KarlaRuggaber/hands-on-HCI/hardware/steckplan/Group4-Spicetracks-Circuit-Diagram.html

Spicetracks · Elektronik

# Steckplan: ESP32-S3, zwei Breadboards, Relais, Pumpe, Motor, LEDs, Lichtsensor, Pi und vier Kräuter

Jedes Kabel ist eingezeichnet, mit Pin, Loch und Kabeltyp. Fahr mit der Maus über ein Kabel oder tipp es an, dann siehst du oben genau, von wo nach wo es geht. Mit den Knöpfen hebst du einen Bereich hervor.

Breadboard 1: 3,3 V Breadboard 2: 5 V vom ELEGOO Power MB V2 Relais: Reihe 10 Touch: Reihen 2 · 12 · 19 · 26 Feuchte: Reihen 6 · 16 · 23 · 30 Motor: GPIO 15 bis 18 LEDs: GPIO 40, Strom aus der Powerbank Licht KY-054: GPIO 6, Reihe 11

Ganzes Bild Vergrössern

Pin-Reihenfolge nach dem Espressif ESP32-S3-DevKitC-1. Bei einem Nachbau zählt der Aufdruck auf eurem Board. Breadboard 1 nutzt Reihen bis 30, Breadboard 2 Reihen bis 20; auf grösseren Boards gelten dieselben Nummern.

## Kabelliste

Nr | Von | Nach | Kabel | Wozu

## Regeln beim Stecken

1. Nur ohne Strom stecken: USB abziehen und das ELEGOO-Modul ausschalten.
2. ELEGOO Power MB V2: beide Jumper auf 5 V, Plus-Pins auf die rote Schiene. Es liefert höchstens etwa 700 mA, deshalb hängen Relais, Motor und Pumpe daran, die LEDs nicht.
3. Breadboard 1 führt auf den roten Schienen 3,3 V, Breadboard 2 führt 5 V. Die roten Schienen der beiden Boards nie miteinander verbinden.
4. Der 5V-Pin des ESP32 bleibt frei. Der ESP32 bekommt seinen Strom nur über USB vom Pi, nie zusätzlich vom Netzteil.
5. Gemeinsame Masse: Kabel S5 verbindet GND des ESP32 mit Breadboard 2. Ohne diese Verbindung schalten Relais, Motor und LEDs unzuverlässig.
6. Die Rille in der Mitte trennt a bis e von f bis j. Deshalb sitzen Widerstände und Brücken über der Rille.
7. Obere und untere Schienen eines Boards sind getrennt. Die Brücken verbinden sie.
8. Kondensator 1000 µF: nur für die LED-Versorgung, direkt am Eingang des Bügels. Der Streifen mit dem Minuszeichen kommt an GND.
9. Powerbank Intenso B10000: höchstens 2,4 A, deshalb LEDs im Code auf 1500 mA begrenzen. Schaltet sie ab, wenn alle LEDs dunkel sind, lasst ein leichtes Grundglimmen an.
10. Der Lichtsensor KY-054 bekommt nur 3,3 V. Mit 5 V wäre sein Signal zu hoch für den Analogeingang des ESP32. Am Bügel zeigt er nach oben, weg von den LEDs.
11. LED-Streifen haben eine Richtung. Der Pfeil auf dem Streifen zeigt von DIN nach DOUT. Das Kabel vom Breadboard kommt an DIN.
12. Touch-Kabel einzeln führen, nicht neben Motor- oder Pumpenkabeln.

## LED-Nummern für den Code

Stück | LED-Nummern | Hinweis
Bügel | 0 bis 27 | 0 sitzt am Kabelanfang rechts
Kraut 1 | 28 bis 30 | 3er-Stück innen am Trog
Kraut 2 | 31 bis 33
Kraut 3 | 34 bis 36
Kraut 4 | 37 bis 39 | Ende der Kette

Helligkeit im Code begrenzen, z. B. mit FastLED setMaxPowerInVoltsAndMilliamps(5, 1500). 40 LEDs auf Vollweiss brauchen sonst bis 2,4 A.

## Kommt später dazu

Teil | Pin | Hinweis
Tank-Füllstand | GPIO 7 | 5. Feuchtesensor am Tank oder Schwimmer gegen GND
Endschalter Verteiler | GPIO 39 | INPUT_PULLUP, Schalter gegen GND
Pegelwandler 74AHCT125 | GPIO 40 | nur falls die LEDs flackern, zwischen GPIO 40 und 330 Ω
