KarlaRuggaber/hands-on-HCI/hardware/3d-druck/spicetracks-dach-druckplan.pdf

# Spicetracks Dach, Variante B „Wild gewachsen“

Für Bambu-Drucker mit 256 × 256 × 256 mm. Unterkante Hauptast 30 cm über der Box, Stämme hinten in den beiden Enden des Elektronikschachts. Alles wird gesteckt, nichts geklebt. Ohne Kamera.

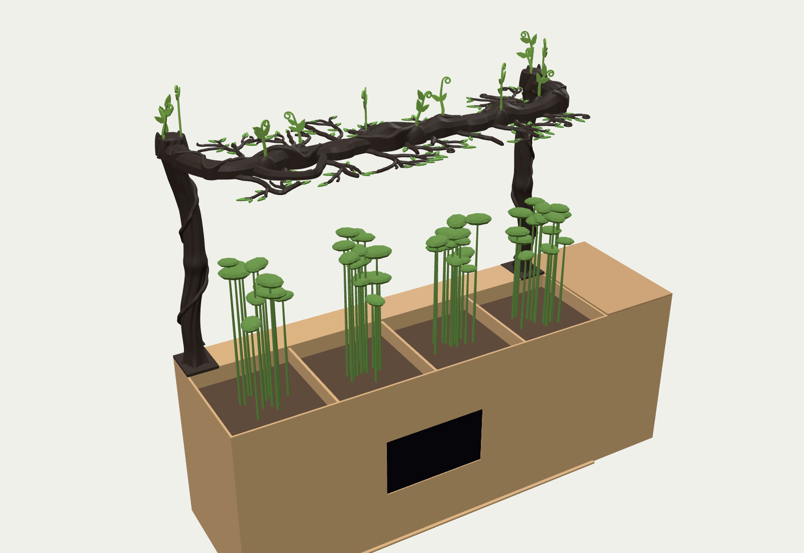
[picture p2: figure]

## Was drin ist

Stämme statt Pfosten: zwei Teile pro Stamm, gebogen und leicht verdreht, mit Rindenrillen, einem Knoten an der Steckstelle, Wurzeln auf dem Fuss und einer Ranke, die sich hochwindet. Innen hohl für die Kabel.
Kronen: Jeder Stamm endet oben in einem knorrigen Kopf, aus dem der Hauptast wächst.
Hauptast: Wülste und Buckel, darüber windet sich eine Liane. An drei Stellen wächst ein zweiter Strang heraus und wieder hinein, dort entstehen offene Schlaufen. Zweige und Blätter flach mitgedruckt, mit Blattbüscheln und kleinen Rankenspiralen an den Spitzen. Blätter grün über das AMS.
Steck-Triebe: 16 flache grüne Triebe für 13 Schlitze oben auf Kronen und Wülsten, drei als Reserve. Man kann sie jederzeit umstecken.
Technik wie bisher: LED-Nut 11 × 6 mm unten für einen 10-mm-Streifen, 467 mm lang (28 LEDs bei 60/m), Kabelkanal im Ast bis in die Stämme, Loch Ø 5.3 mm für den Lichtsensor rechts, Schwalbenschwanz-Fugen zwischen den drei Dachteilen.

## Druckplatten

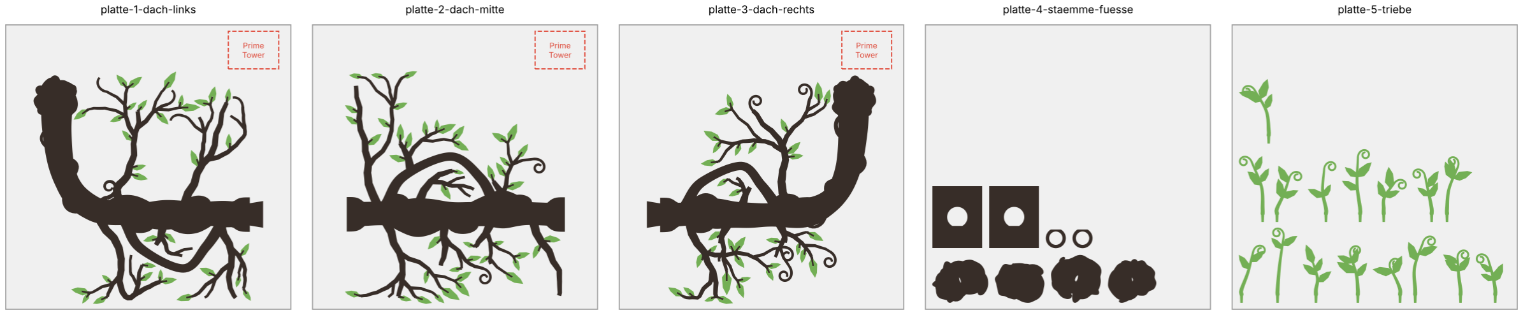
[picture p3: figure]

Platte Teil | Grösse mm | Lage
1 | Dach links | Ast + Blätter 206 × 209 × 31 flach, wie geliefert
2 | Dach Mitte | Ast + Blätter 198 × 209 × 31 flach, wie geliefert
3 | Dach rechts | Ast + Blätter 206 × 205 × 30 flach, wie geliefert
4 | Stamm links unten / oben | je 1× | 50 × 39 × 164 | stehend, Knoten auf dem Bett, Brim
4 | Stamm rechts unten / oben je 1× | 45 × 43 × 164 | stehend, Knoten auf dem Bett, Brim
4 | Pfostenfuss links + rechts | 2× | 45 × 56 × 44 | Deckel nach unten
4 | Dübel | 2× | 18 × 17 × 31 | stehend
5 | Triebe | 16× | bis 30 × 60 × 2 flach, grün

## Einstellungen

PETG, Schichthöhe 0.2 mm, 3 Wände, 15 % Infill, keine Stützen. Überhänge sind höchstens 45°, dazu kurze Brücken über Nut, Kanal und Buchsen.
Platten 1 bis 3 zweifarbig: Jede 3MF enthält ein Objekt mit den Teilen „Ast“ und „Blaetter“. Den Blättern im AMS grünes Filament zuweisen. Die Dachteile liegen vorne, hinten bleibt Platz für den Prime Tower (rot markiert). Steht er woanders, nach hinten ziehen.
Platte 4: Brim 5 mm für die Stämme, sie stehen hoch und schmal. Die unteren Stücke stehen kopfüber, die Wurzeln sind oben.
Platte 5: einfarbig grün, gern ein helleres Grün als die Blätter.
Feine Zweige: Aussenwände etwa 60 mm/s, falls Spitzen abreissen.
Die einzelnen STL-Dateien liegen auch bei, falls ihr selber anordnen wollt.

## Zusammenbau

1. Schachtdeckel: Der Laser-Deckel (Platte 04) ist 497.5 mm lang und liegt zwischen den beiden Pfostenfüssen.
2. Pfostenfüsse von oben in die Schachtenden stecken. Der Fuss mit dem Loch zur Seitenwand kommt rechts, auf die Tankseite. Der Saugschlauch geht durch Seitenwand und Fuss.
3. Stämme stecken: unteres Stück mit dem Zapfen in den Fuss, Dübel ins untere Stück, oberes Stück darauf. Zapfen und Dübel haben eine flache Seite nach hinten, so passt alles nur in der richtigen Drehung und die Ranke läuft durch. Links und rechts stehen im Dateinamen.
4. Kabel einziehen, bevor das Dach oben ist: LED-Kabel vom linken Ende der Nut durch das kleine Loch in den Kanal und weiter zur linken Krone. Den Lichtsensor oben ins Loch rechts stecken, seine Beine durch den Kanal zur rechten Krone. Ein steifer Draht als Zugdraht hilft. Stecker dürfen höchstens 11 mm breit sein, sonst erst nachher ancrimpen.
5. Dach zusammenstecken, auf dem Tisch: Aussenteile hinlegen, das Mittelteil von oben auf die beiden Zapfen setzen.
6. LED-Streifen in die Nut kleben, LEDs nach unten. Er läuft am Stück über beide Fugen und hält das Dach zusätzlich zusammen.
7. Dach aufsetzen: mit den Kronen auf die oberen Stammzapfen stecken. Die Kabel kommen durch die hohlen Stämme unten im Schacht an.
8. Triebe einstecken: Zapfen in die Schlitze drücken. Der Zapfen ist keilförmig und klemmt. Sitzt einer zu locker, einen anderen Trieb nehmen.

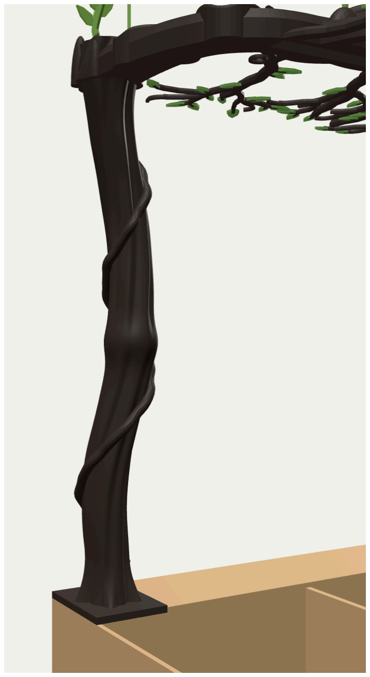
[picture p4: figure]

## Kabel

LED-Streifen: 3 Adern (5 V, GND, Daten) durch den linken Stamm zum ESP32 im Schacht. Lichtsensor: 2 Adern durch den rechten Stamm.
Die Pfostenfüsse belegen die obersten 4.5 cm an beiden Schachtenden. Platinen dort tiefer oder weiter innen montieren.

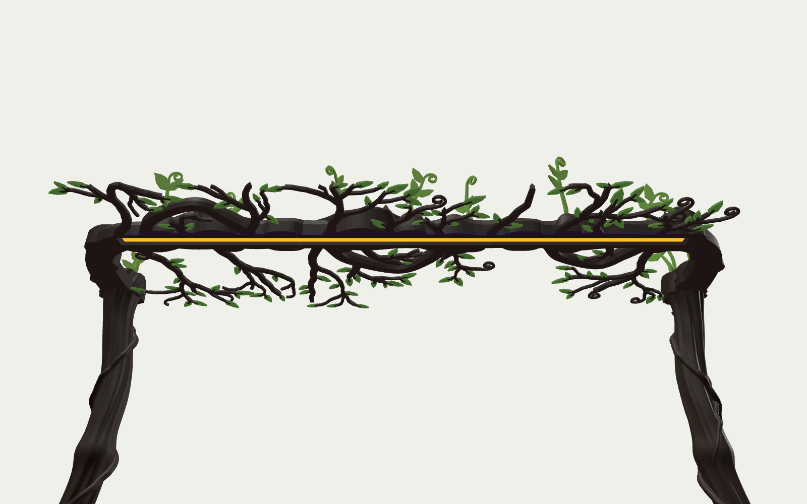
[picture p5: figure]

Von unten: LED-Nut, Schlaufen und Zweige rund um den Hauptast.

Stamm links: Wurzeln auf dem Fuss, Knoten an der Steckstelle, Ranke.
