KarlaRuggaber/hands-on-HCI/docs/skizzen/Bleistiftskizze.pdf

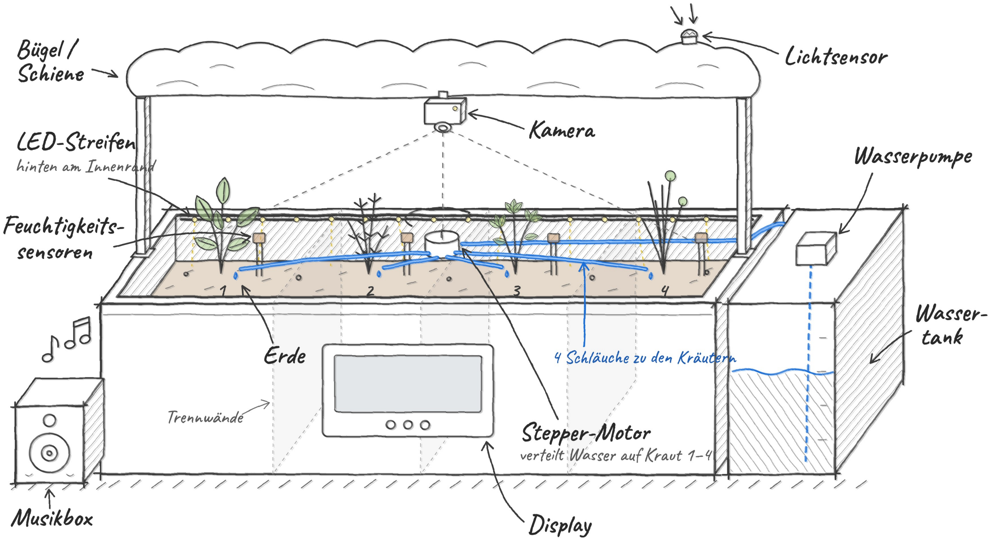
[picture p6: page 1]

1 | 2 | 3 | 4

Feuchtigkeitssensoren

LED-Streifen
hinten am Innenrand

Erde

Trennwände

Lichtsensor

Kamera

Bügel /
Schiene

Stepper-Motor
verteilt Wasser auf Kraut 1–4

Wasserpumpe

Wassertank
4 Schläuche zu den Kräutern
Musikbox | Display
