KarlaRuggaber/hands-on-HCI/docs/skizzen/Kräutergarten Dach-Ideen-selection.pdf

# Querschnitt LED-Kanal

# Teile verbinden & Kamera

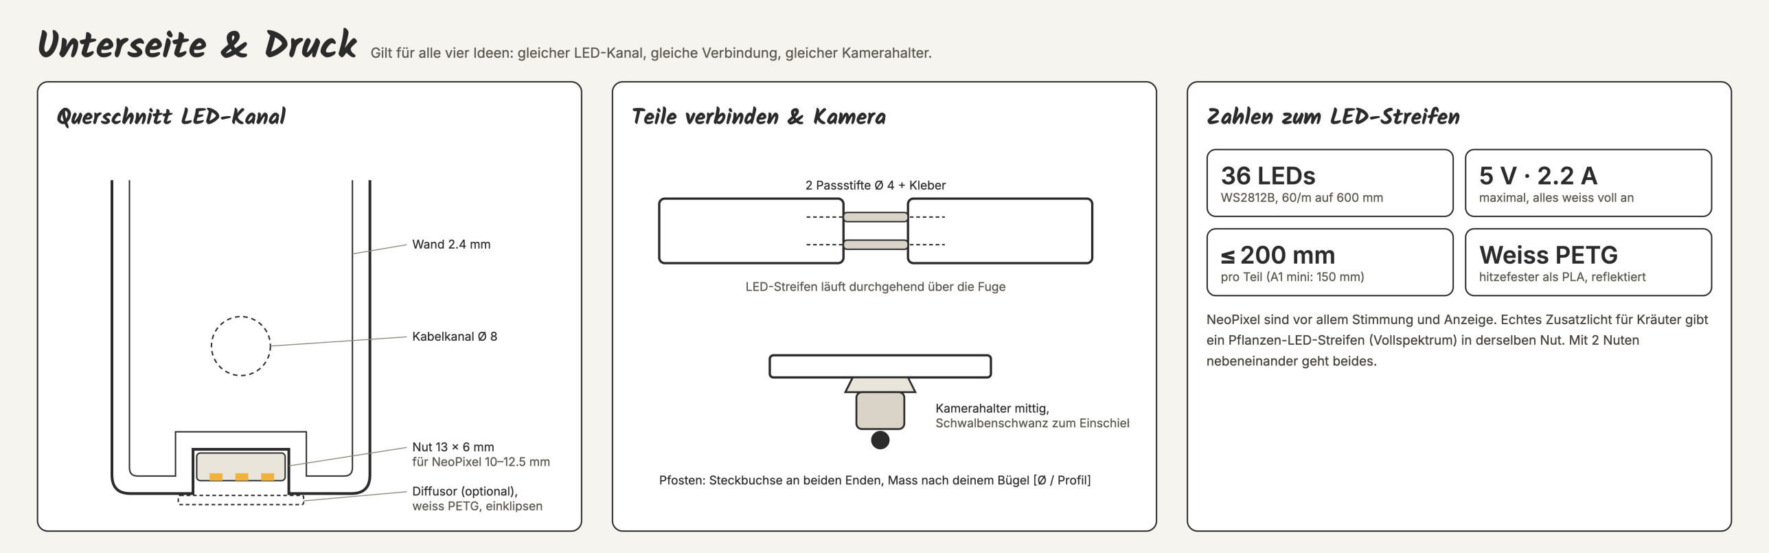
[picture p7: page 1]

Unterseite & Druck Gilt für alle vier Ideen: gleicher LED-Kanal, gleiche Verbindung, gleicher Kamerahalter.

Wand 2.4 mm

Kabelkanal Ø 8

Nut 13 × 6 mm
für NeoPixel 10–12.5 mm

Diffusor (optional),
weiss PETG, einklipsen

2 Passstifte Ø 4 + Kleber

LED-Streifen läuft durchgehend über die Fuge

Kamerahalter mittig,
Schwalbenschwanz zum Einschieben

Pfosten: Steckbuchse an beiden Enden, Mass nach deinem Bügel [Ø / Profil]

# Zahlen zum LED-Streifen

# 36 LEDs

WS2812B, 60/m auf 600 mm

5 V · 2.2 A

maximal, alles weiss voll an

≤ 200 mm

pro Teil (A1 mini: 150 mm)

# Weiss PETG

hitzefester als PLA, reflektiert

NeoPixel sind vor allem Stimmung und Anzeige. Echtes Zusatzlicht für Kräuter gibt ein Pflanzen-LED-Streifen (Vollspektrum) in derselben Nut. Mit 2 Nuten nebeneinander geht beides.

# Dicker Ast pro Kraut

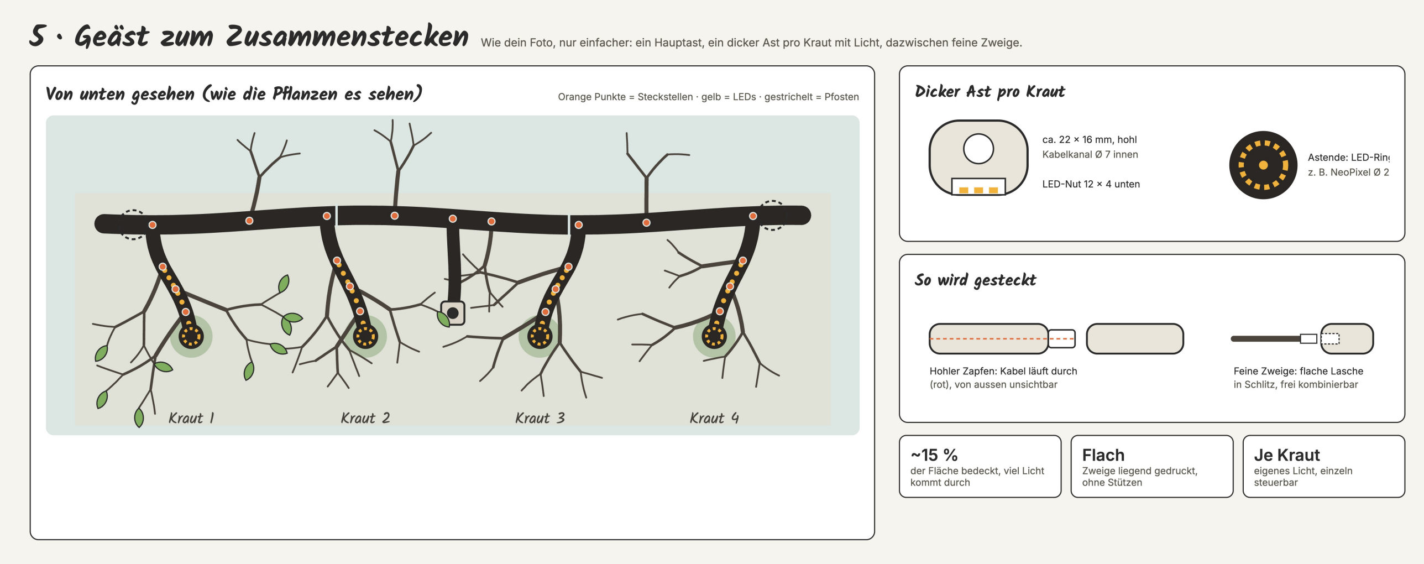
[picture p8: page 2]

5 · Geäst zum Zusammenstecken Wie dein Foto, nur einfacher: ein Hauptast, ein dicker Ast pro Kraut mit Licht, dazwischen feine Zweige.

Von unten gesehen (wie die Pflanzen es sehen) | Orange Punkte = Steckstellen · gelb = LEDs · gestrichelt = Pfosten
Kraut 1 | Kraut 2 | Kraut 3 | Kraut 4

ca. 22 × 16 mm, hohl
Kabelkanal Ø 7 innen

LED-Nut 12 × 4 unten

Astende: LED-Ring
z. B. NeoPixel Ø 23–32

# So wird gesteckt

Hohler Zapfen: Kabel läuft durch (rot), von aussen unsichtbar

Feine Zweige: flache Lasche in Schlitz, frei kombinierbar

~15 %

der Fläche bedeckt, viel Licht kommt durch

# Flach

Zweige liegend gedruckt,
ohne Stützen

# Je Kraut

eigenes Licht, einzeln
steuerbar

# A · Symmetrisch

Gleichmässige Äste im Takt, links und rechts gespiegelt. Ruhig und aufgeräumt.

## vorne

## hinten

Alle Seitenäste gleich, nur 2 Formen drucken | Rhythmus 70 mm, passt zu jedem Kraut | ~15 % der Fläche bedeckt

# B · Wild gewachsen

Leicht gewellter Hauptast, unregelmässige Äste, mehr Zweige. Am nächsten an deinem Foto.

## vorne

## hinten

Jeder Seitenast anders, wirkt wie echter Baum

Feinste Zweige ca. 1.5 mm, langsam drucken | ~22 % der Fläche bedeckt

# C · Gabel pro Kraut

Über jedem Kraut gabelt sich ein V nach vorne und hinten. Man sieht sofort, welches Licht zu welcher Pflanze gehört.

## vorne

## hinten

4 Gabel-Module, je eins pro Kraut | Optional LED in den Gabelästen | ~18 % der Fläche bedeckt

# D · Minimal

Wenige lange, feine Äste und kaum Blätter. Sehr leicht, fast nur Linie.

## vorne

## hinten

Nur 9 Seitenäste, alle flach druckbar | Wenig Material, sehr schnell gedruckt | ~10 % der Fläche bedeckt
