KarlaRuggaber/hands-on-HCI/docs/abbildungen/entwuerfe.jpg

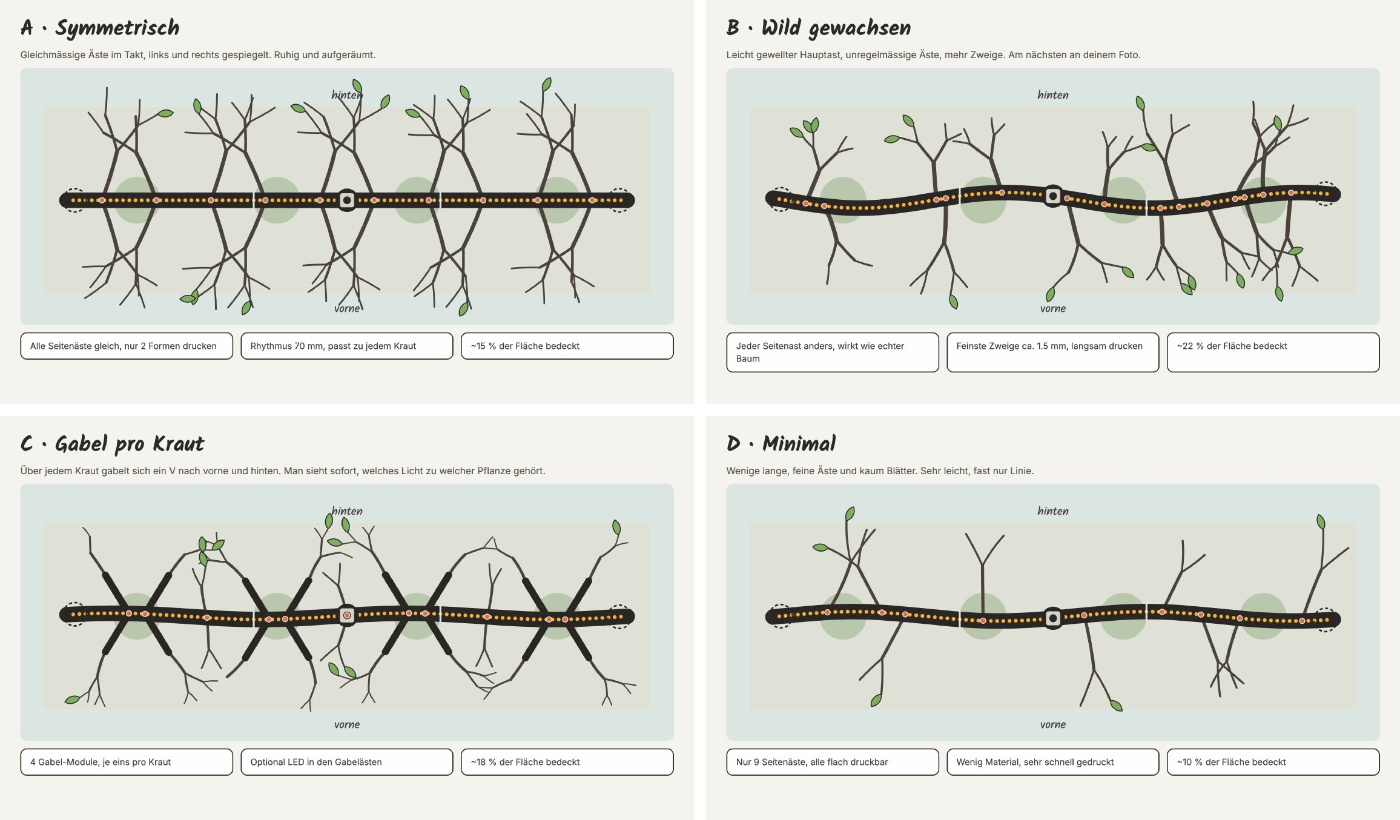
docs/abbildungen/entwuerfe.jpg
