KarlaRuggaber/hands-on-HCI/docs/abbildungen/gehaeuse.jpg

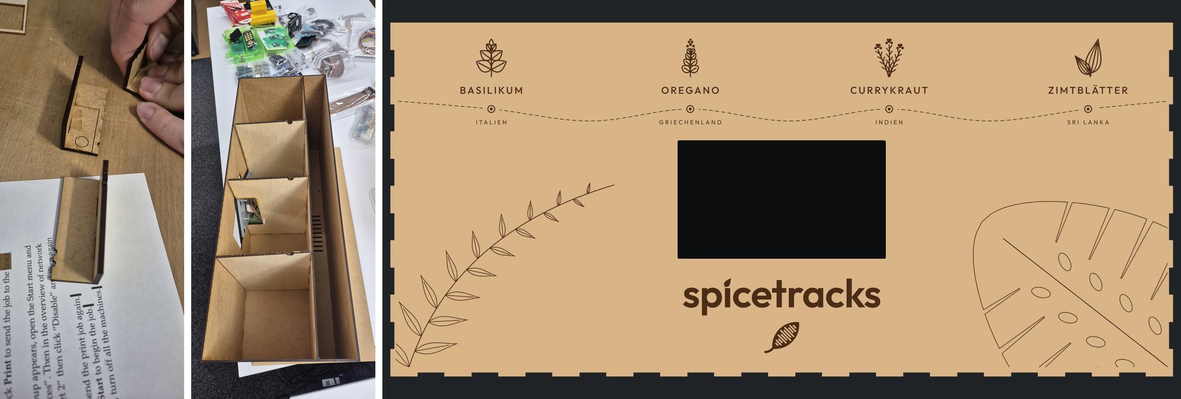
docs/abbildungen/gehaeuse.jpg
