KarlaRuggaber/hands-on-HCI/docs/abbildungen/licht.jpg

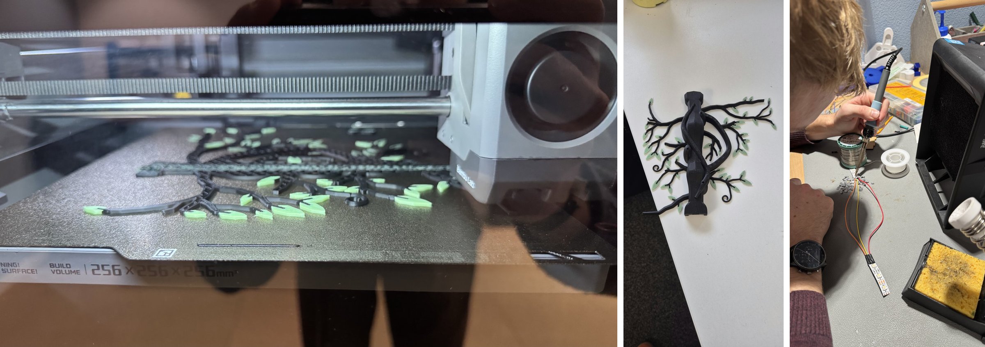
docs/abbildungen/licht.jpg
