KarlaRuggaber/hands-on-HCI/docs/abbildungen/musik.jpg

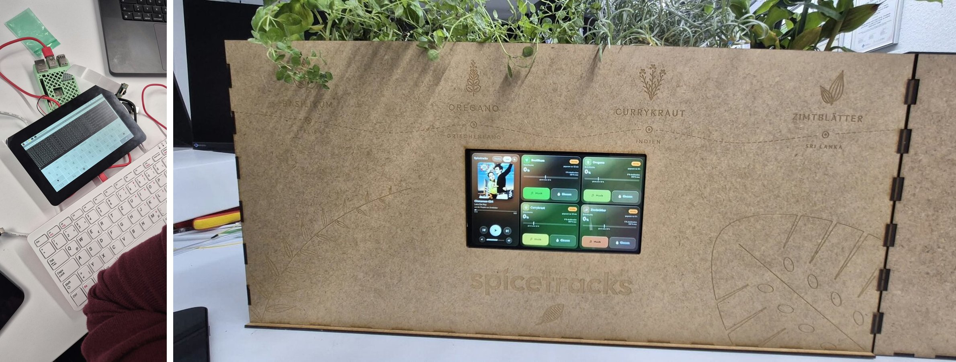
docs/abbildungen/musik.jpg
