KarlaRuggaber/hands-on-HCI/docs/abbildungen/skizzen.jpg

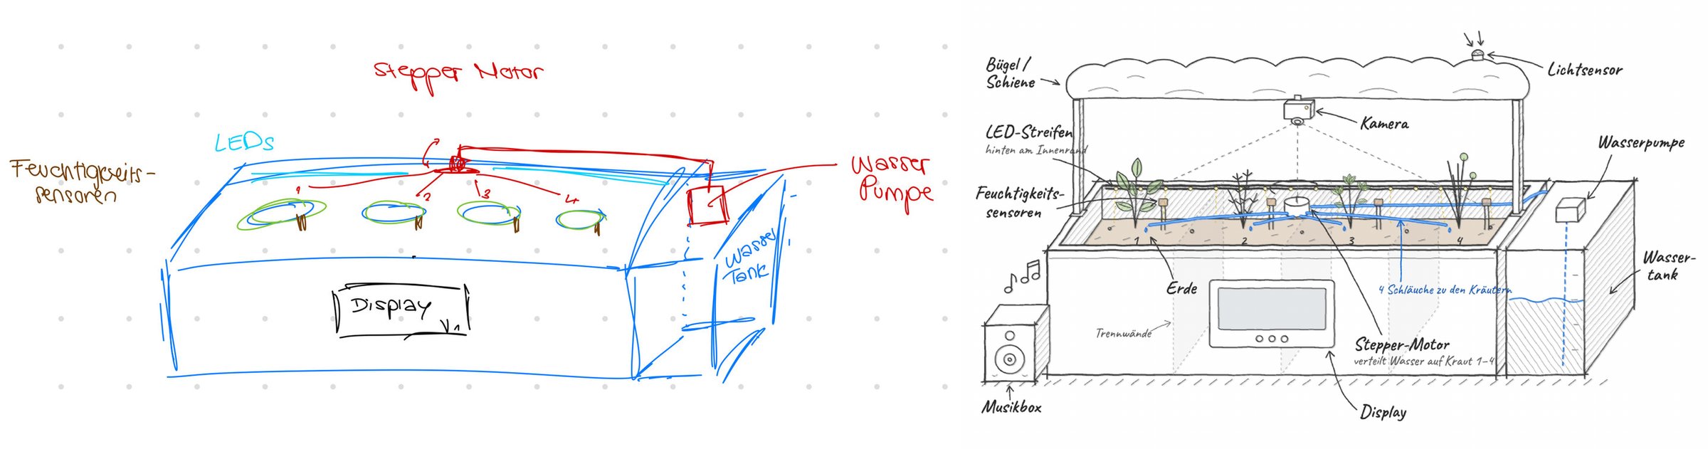
docs/abbildungen/skizzen.jpg
