KarlaRuggaber/hands-on-HCI/docs/abbildungen/steckplan.jpg

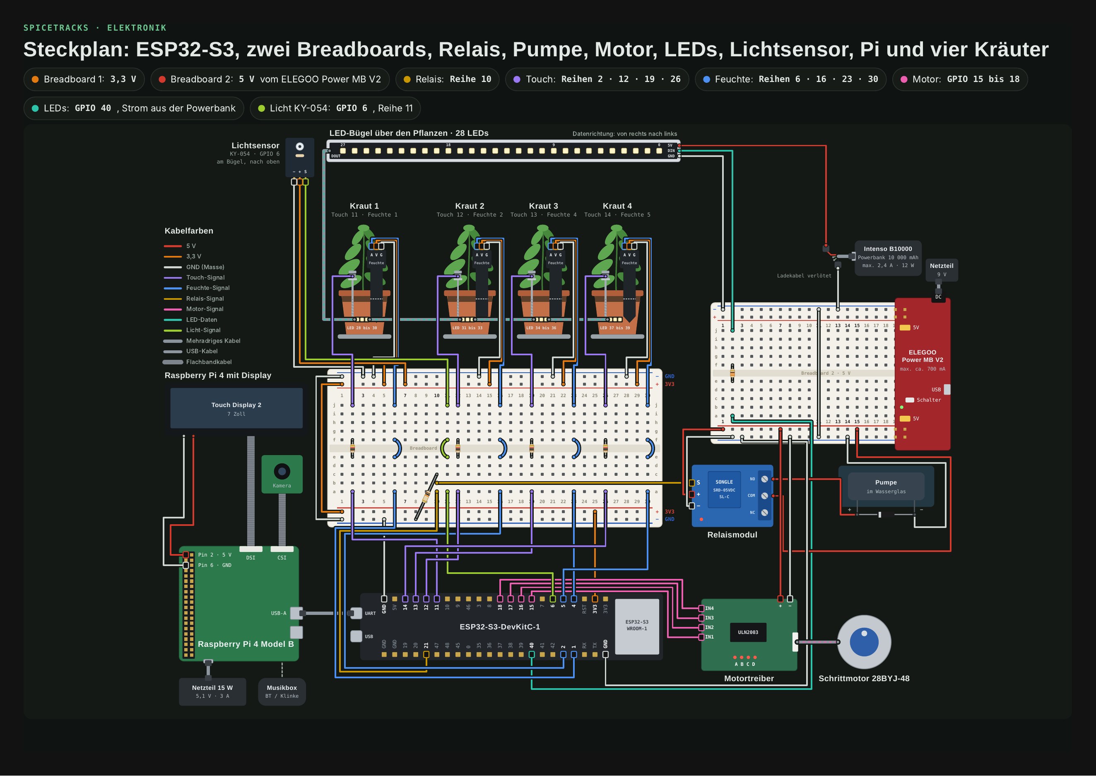
docs/abbildungen/steckplan.jpg
