KarlaRuggaber/hands-on-HCI/docs/abbildungen/touch.jpg

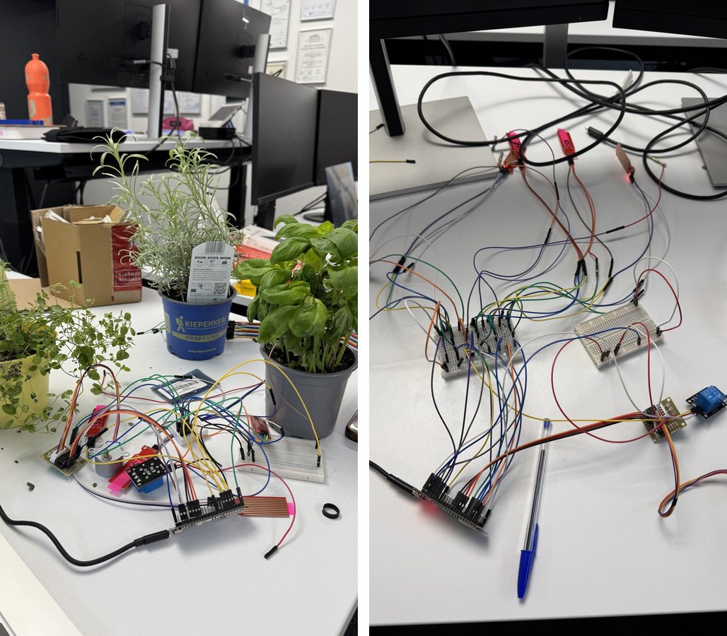
docs/abbildungen/touch.jpg
