KarlaRuggaber/hands-on-HCI/docs/abbildungen/wasser.jpg

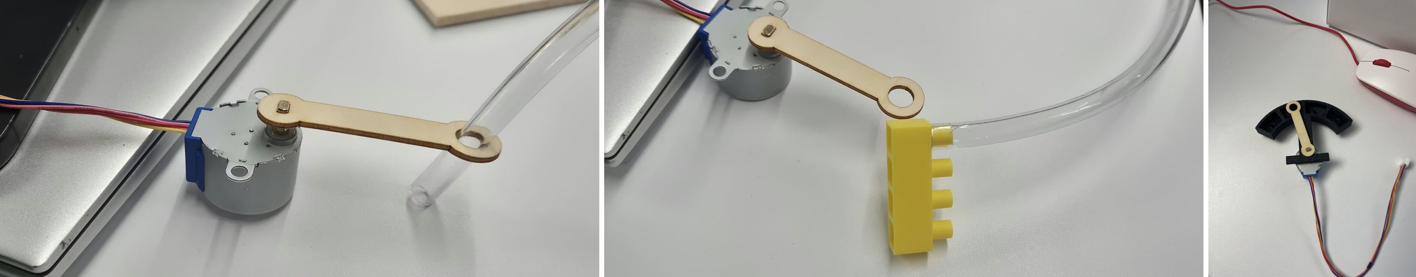
docs/abbildungen/wasser.jpg
