KarlaRuggaber/hands-on-HCI/docs/abbildungen/zusammenbau.jpg

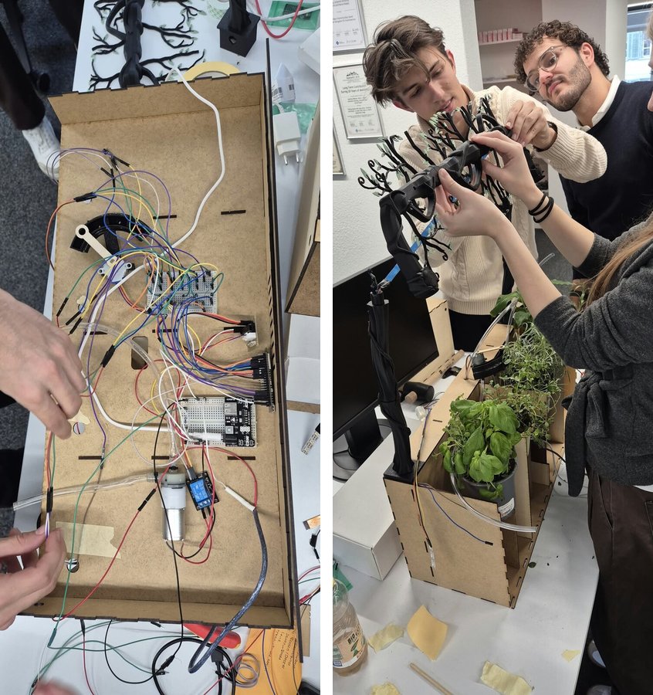
docs/abbildungen/zusammenbau.jpg
