KarlaRuggaber/hands-on-HCI/docs/fotos/Frontseite gehäuse.jpeg

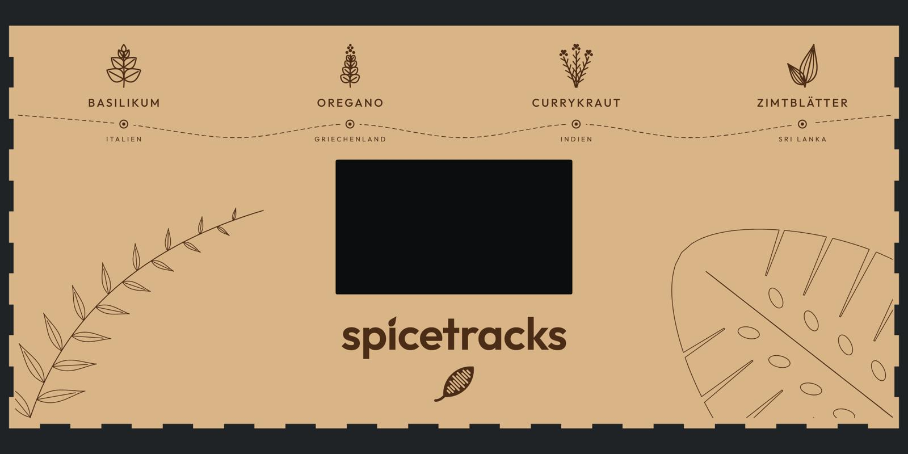
docs/fotos/Frontseite gehäuse.jpeg
