KarlaRuggaber/hands-on-HCI/docs/fotos/IMG_7547.jpg

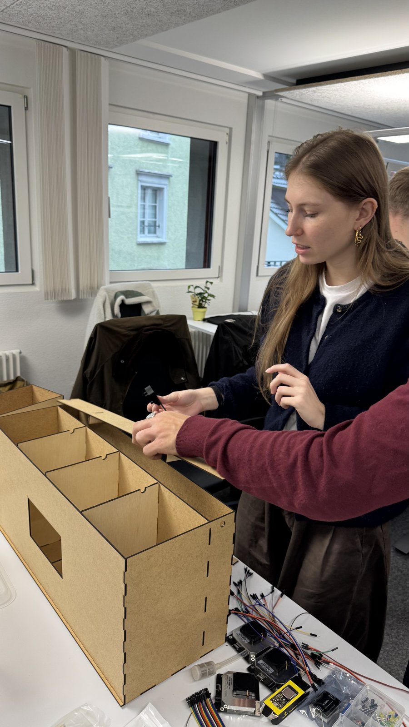
docs/fotos/IMG_7547.jpg
