KarlaRuggaber/hands-on-HCI/docs/fotos/IMG_7548.jpg

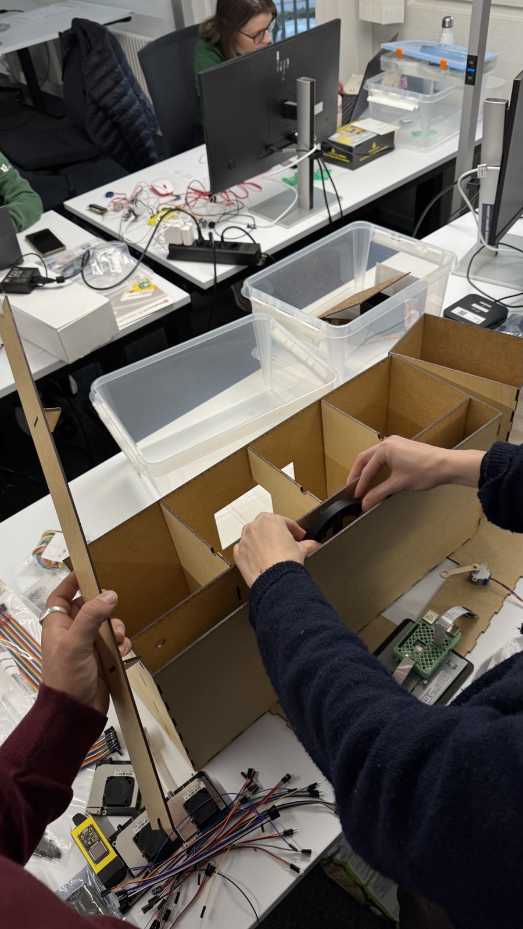
docs/fotos/IMG_7548.jpg
