KarlaRuggaber/hands-on-HCI/docs/fotos/IMG_7551.jpg

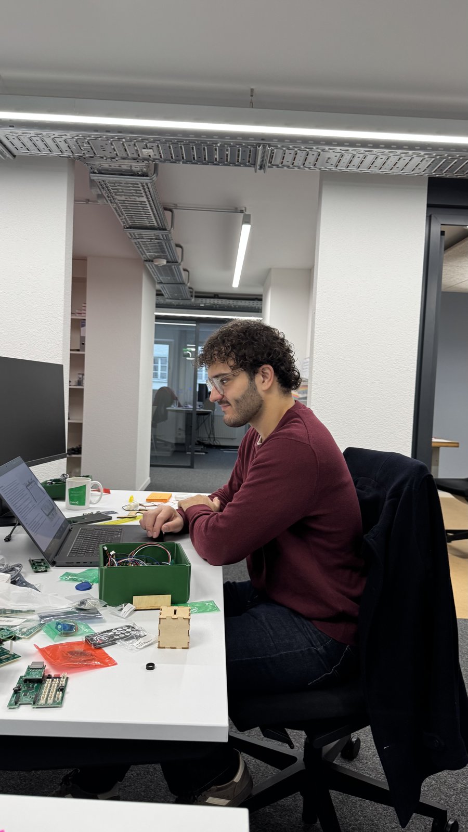
docs/fotos/IMG_7551.jpg
