KarlaRuggaber/hands-on-HCI/docs/fotos/IMG_7552.jpg

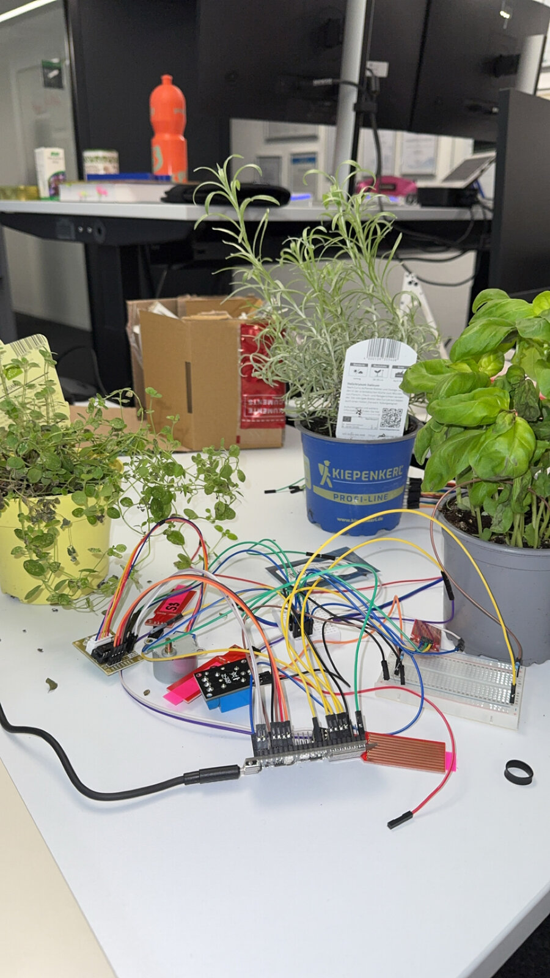
docs/fotos/IMG_7552.jpg
