KarlaRuggaber/hands-on-HCI/docs/fotos/IMG_7553.jpg

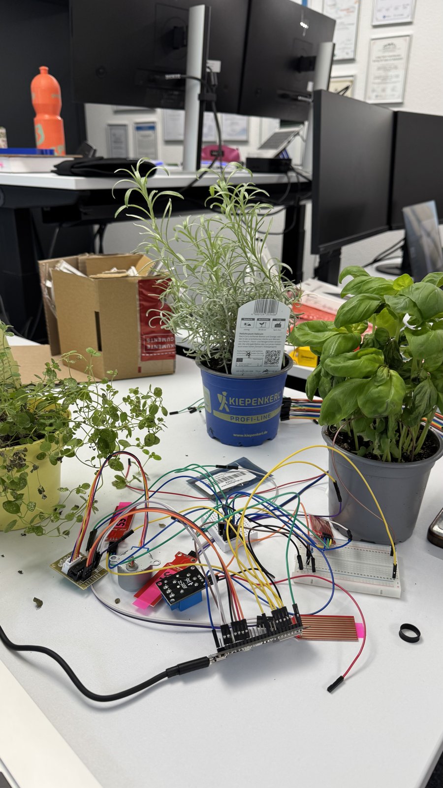
docs/fotos/IMG_7553.jpg
