KarlaRuggaber/hands-on-HCI/docs/fotos/IMG_7554.jpg

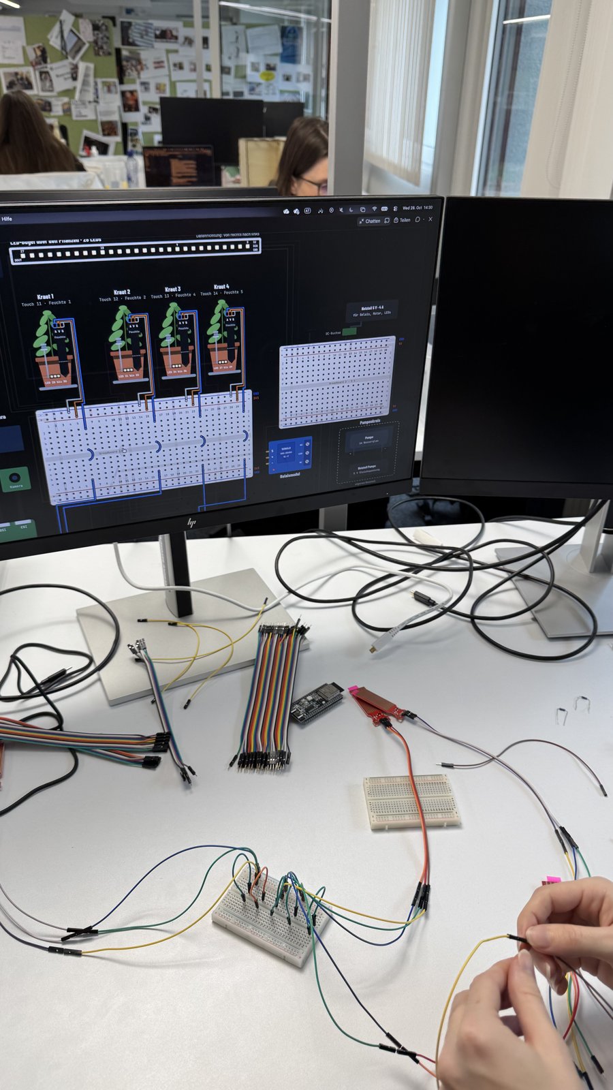
docs/fotos/IMG_7554.jpg
