KarlaRuggaber/hands-on-HCI/docs/fotos/IMG_7556.jpg

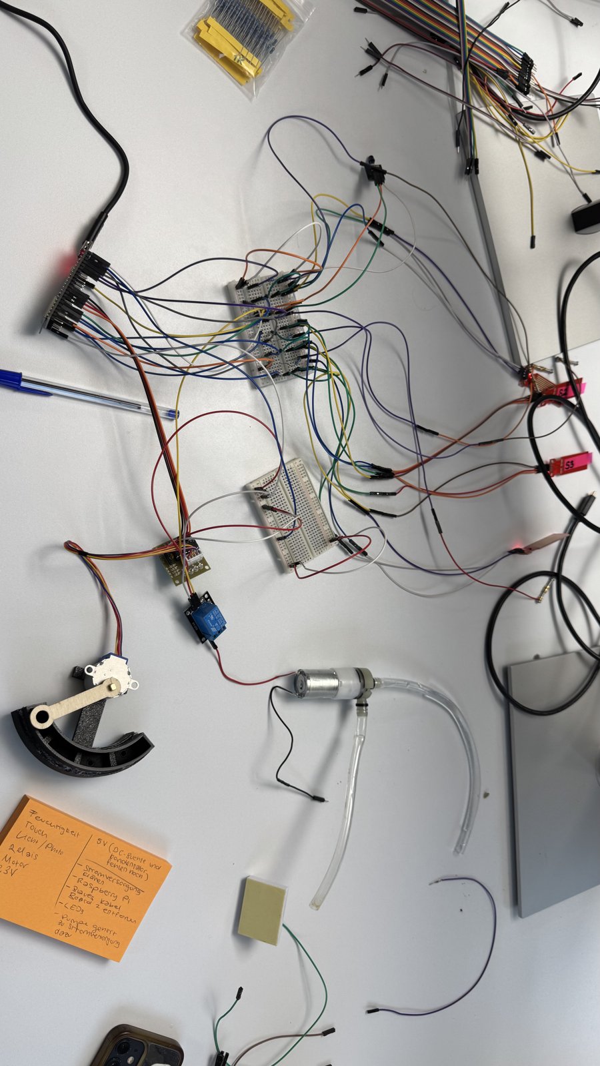
docs/fotos/IMG_7556.jpg
