KarlaRuggaber/hands-on-HCI/docs/fotos/IMG_7557.jpg

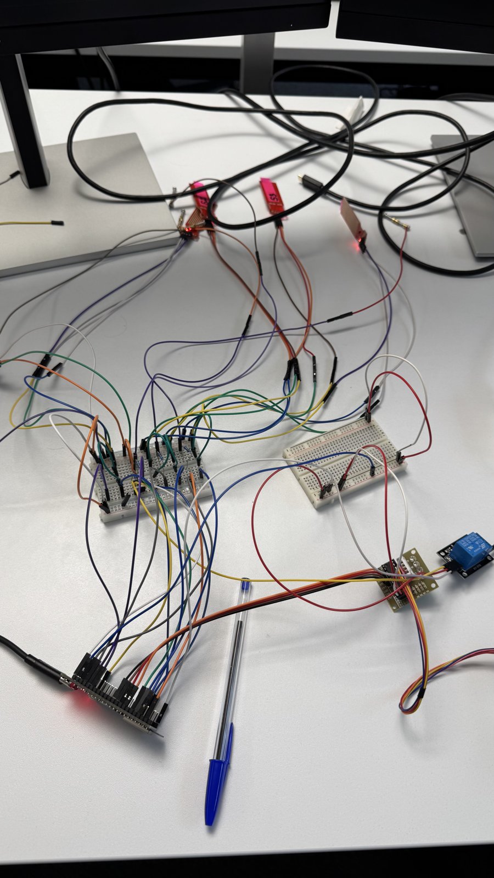
docs/fotos/IMG_7557.jpg
