KarlaRuggaber/hands-on-HCI/docs/fotos/IMG_7559.jpg

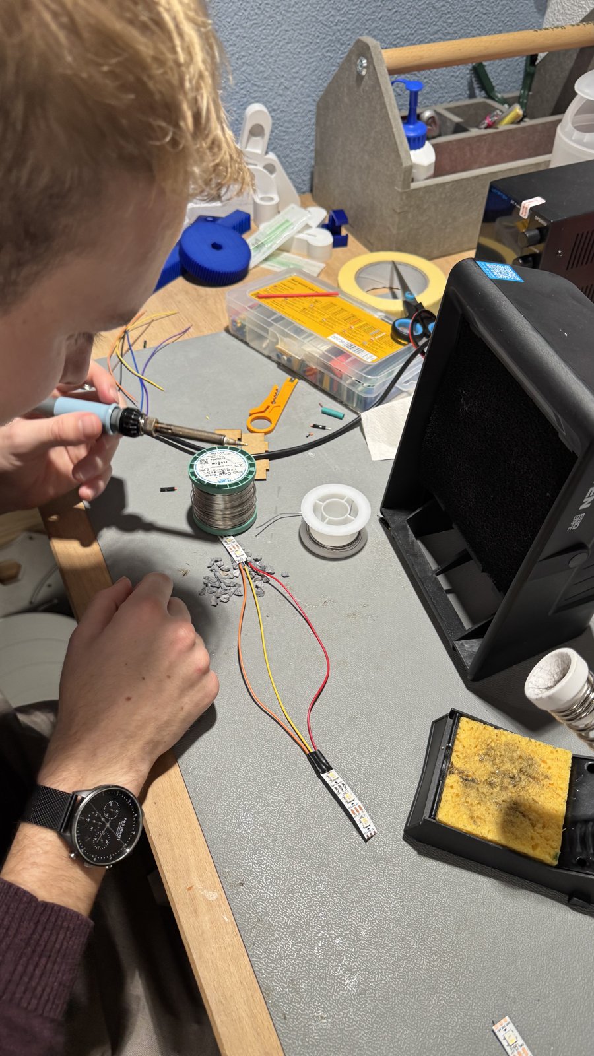
docs/fotos/IMG_7559.jpg
