KarlaRuggaber/hands-on-HCI/docs/fotos/IMG_7560.jpg

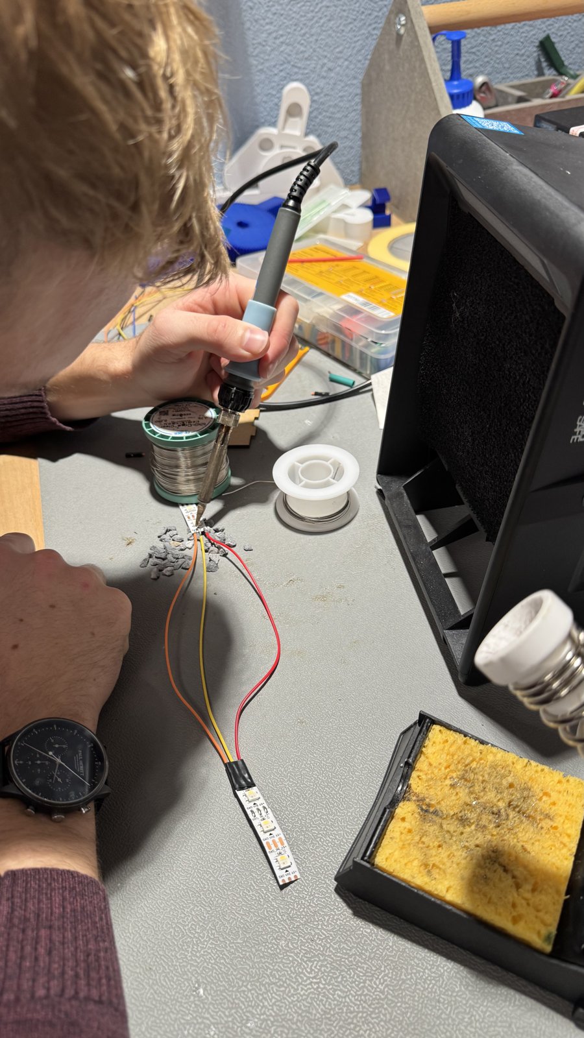
docs/fotos/IMG_7560.jpg
