KarlaRuggaber/hands-on-HCI/docs/fotos/IMG_7561.jpg

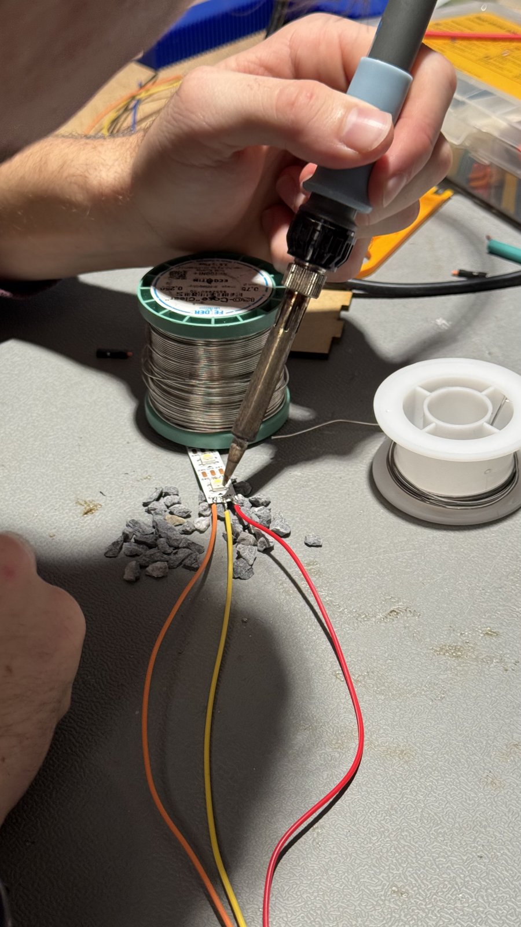
docs/fotos/IMG_7561.jpg
