KarlaRuggaber/hands-on-HCI/docs/fotos/IMG_7562.jpg

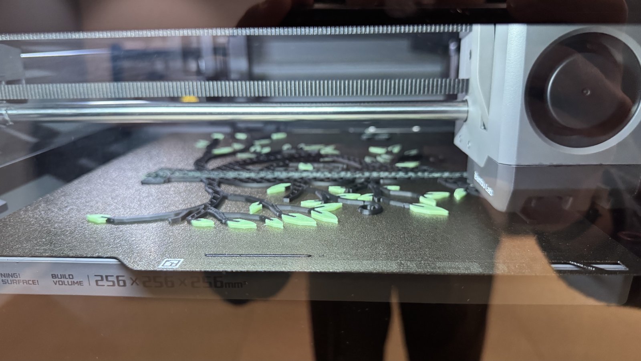
docs/fotos/IMG_7562.jpg
