KarlaRuggaber/hands-on-HCI/docs/fotos/IMG_7575.jpg

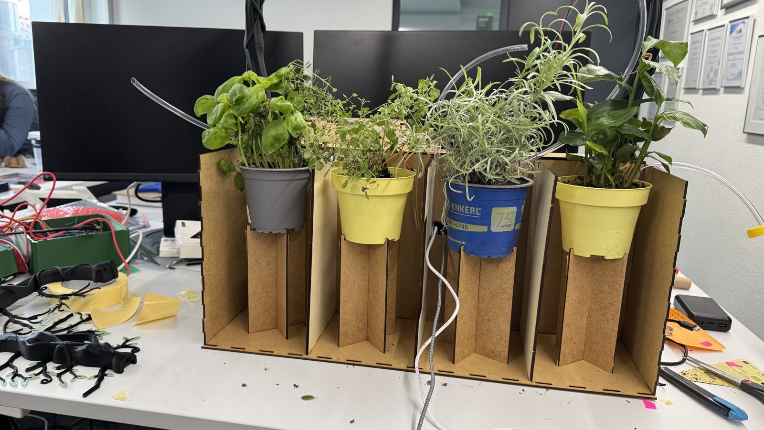
docs/fotos/IMG_7575.jpg
