KarlaRuggaber/hands-on-HCI/docs/fotos/IMG_7577.jpg

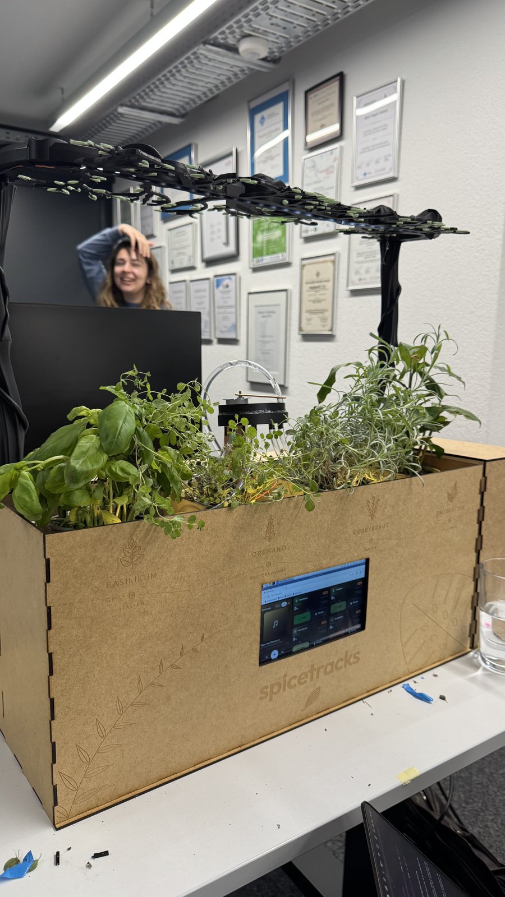
docs/fotos/IMG_7577.jpg
