KarlaRuggaber/hands-on-HCI/docs/fotos/IMG_7578.jpg

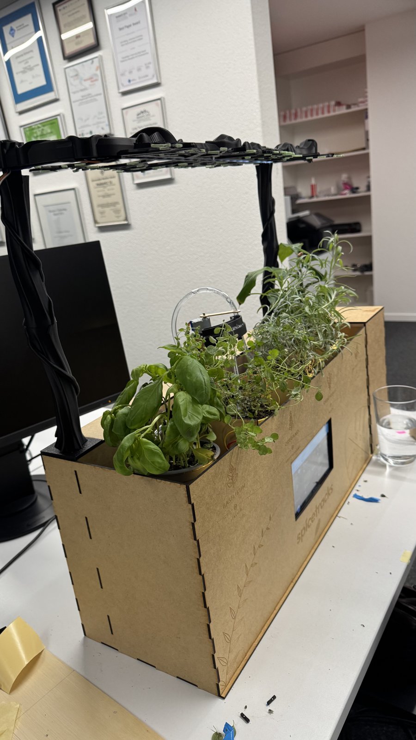
docs/fotos/IMG_7578.jpg
