KarlaRuggaber/hands-on-HCI/docs/fotos/IMG_7579.jpg

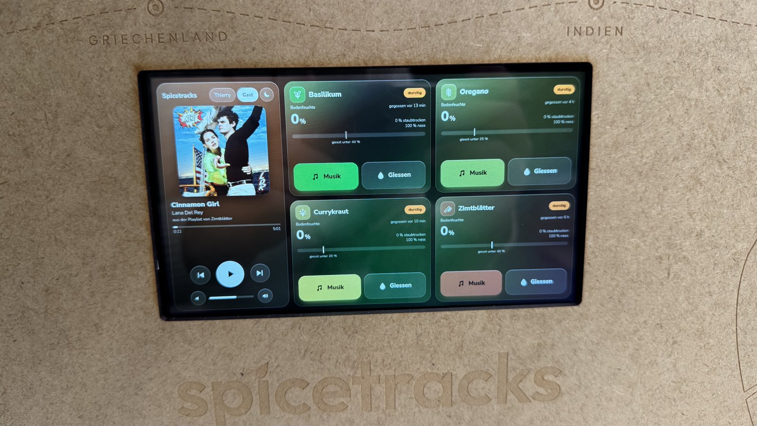
docs/fotos/IMG_7579.jpg
