KarlaRuggaber/hands-on-HCI/docs/fotos/IMG_7580.jpg

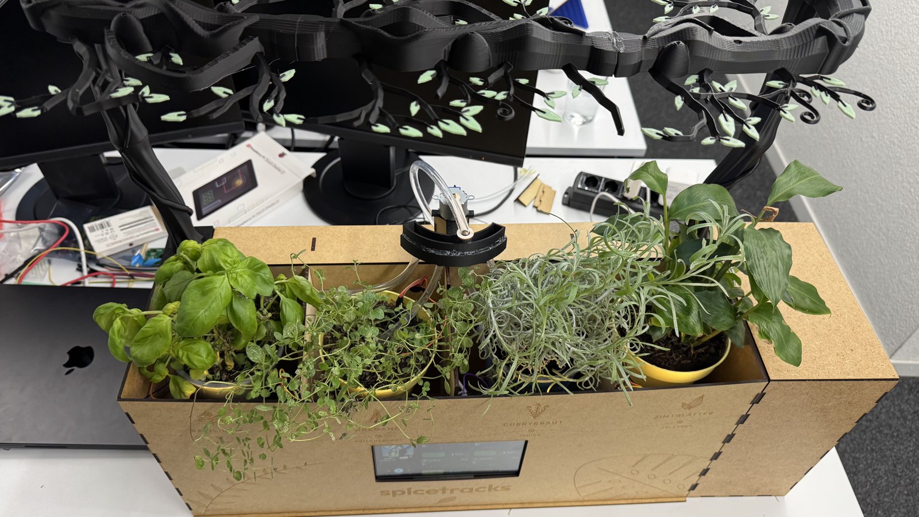
docs/fotos/IMG_7580.jpg
