KarlaRuggaber/hands-on-HCI/docs/fotos/IMG_8983.jpg

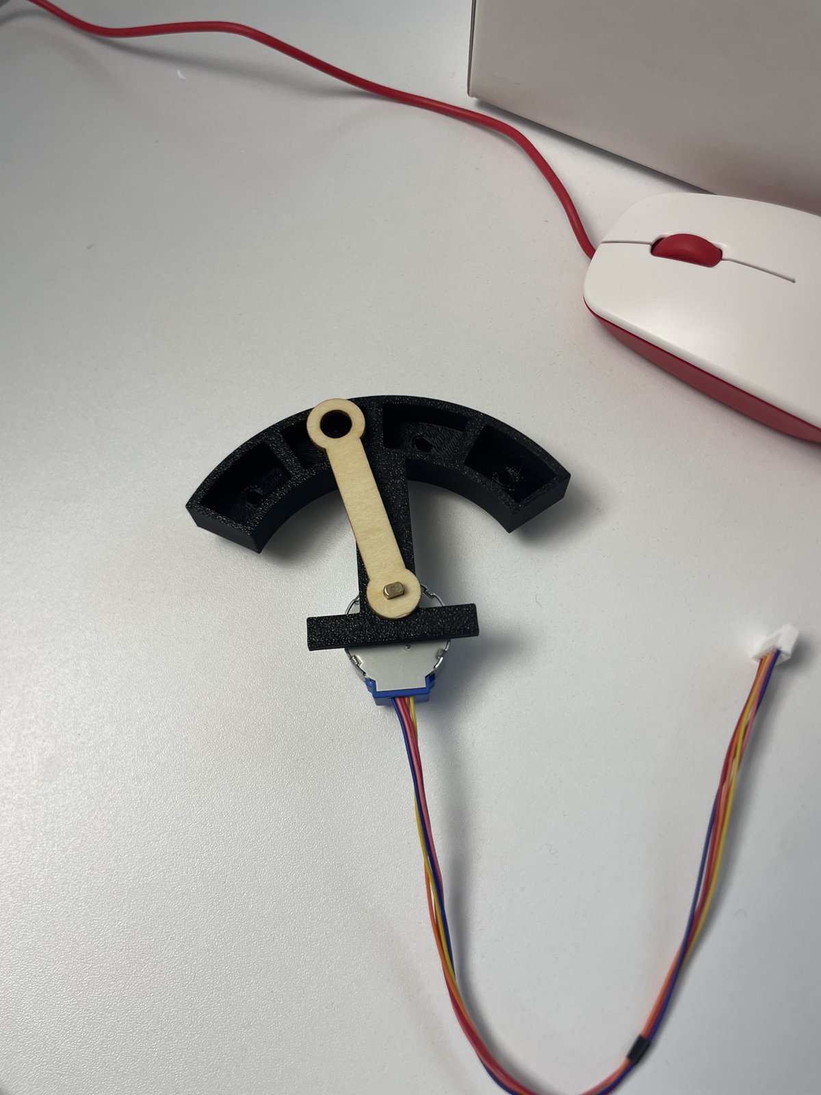
docs/fotos/IMG_8983.jpg
