KarlaRuggaber/hands-on-HCI/docs/fotos/JPEG-Bild-43AC-B767-BC-0.jpg

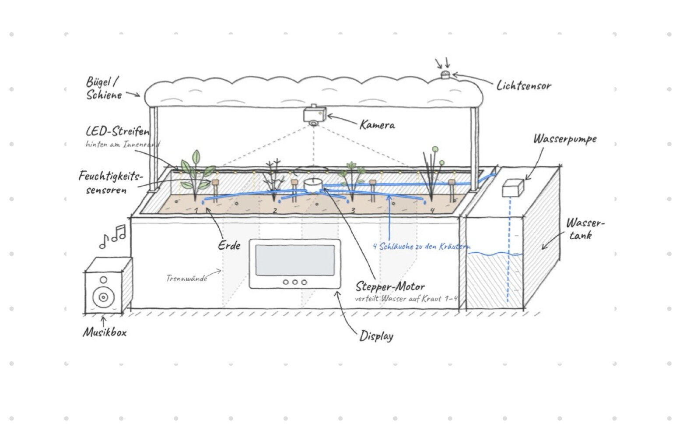
docs/fotos/JPEG-Bild-43AC-B767-BC-0.jpg
