KarlaRuggaber/hands-on-HCI/docs/fotos/JPEG-Bild-416D-A65C-44-0.jpg

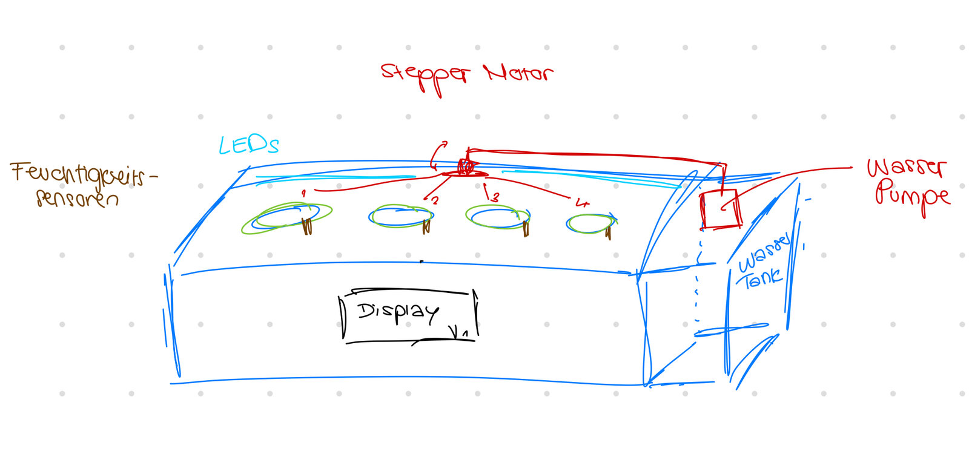
docs/fotos/JPEG-Bild-416D-A65C-44-0.jpg
