KarlaRuggaber/hands-on-HCI/docs/fotos/JPEG-Bild-459A-A401-78-0.jpg

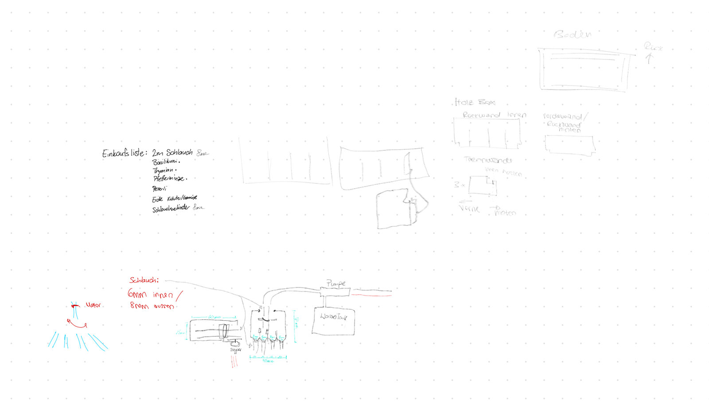
docs/fotos/JPEG-Bild-459A-A401-78-0.jpg
