KarlaRuggaber/hands-on-HCI/docs/fotos/PHOTO-2026-10-30-08-56-53 9.jpg

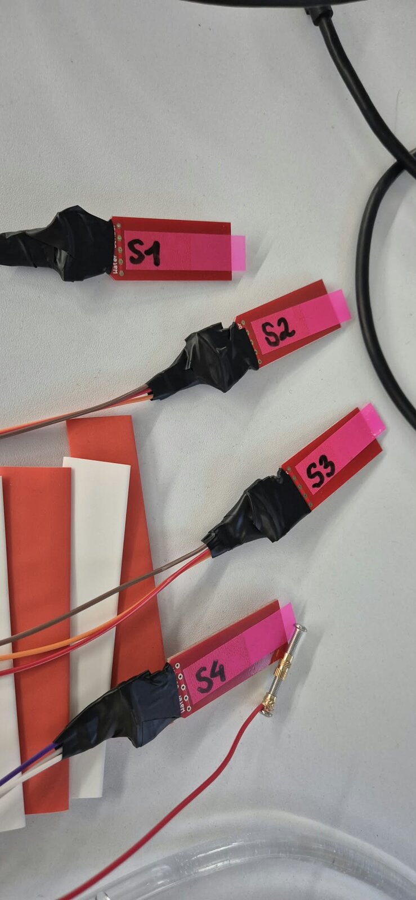
docs/fotos/PHOTO-2026-10-30-08-56-53 9.jpg
