KarlaRuggaber/hands-on-HCI/hardware/3d-druck/stamm-links-unten.stl

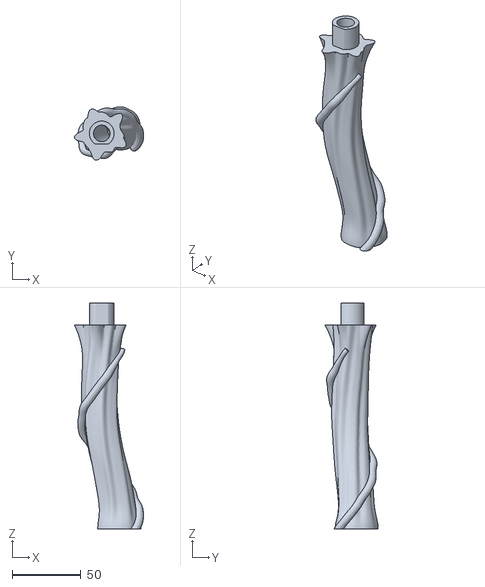
[picture p84: CAD file, 2026-11-12]
hardware/3d-druck/stamm-links-unten.stl
50.2 x 38.8 x 164.0
