KarlaRuggaber/hands-on-HCI/hardware/3d-druck/pfostenfuss-links.stl

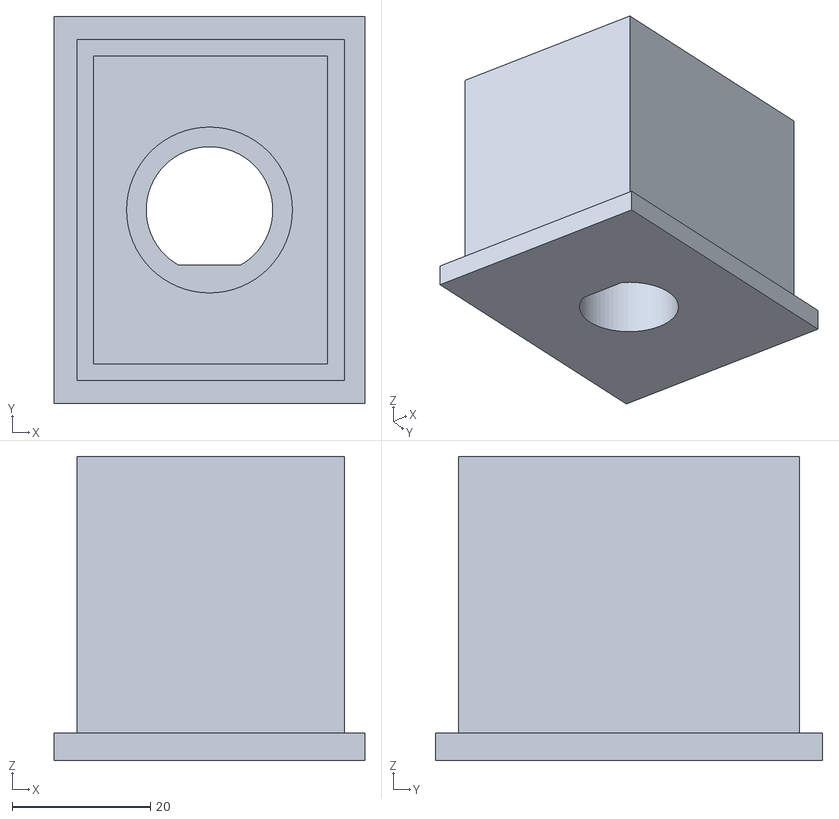
[picture p85: CAD file, 2026-11-12]
hardware/3d-druck/pfostenfuss-links.stl
45.0 x 56.0 x 44.0
