KarlaRuggaber/hands-on-HCI/hardware/3d-druck/platte-2-dach-mitte.3mf

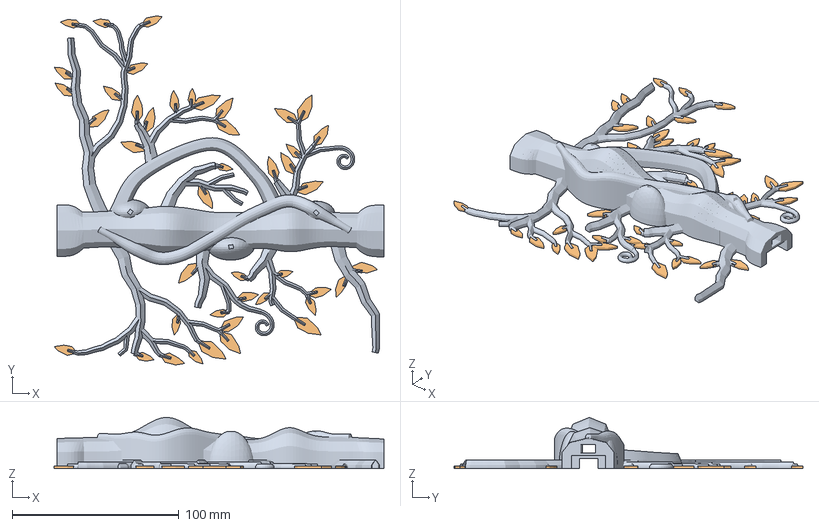
[picture p86: CAD file, 2026-11-12]
hardware/3d-druck/platte-2-dach-mitte.3mf
197.6 x 209.2 x 30.6 mm
Ast mitte
Blaetter mitte
