KarlaRuggaber/hands-on-HCI/hardware/3d-druck/dach-links-blaetter.stl

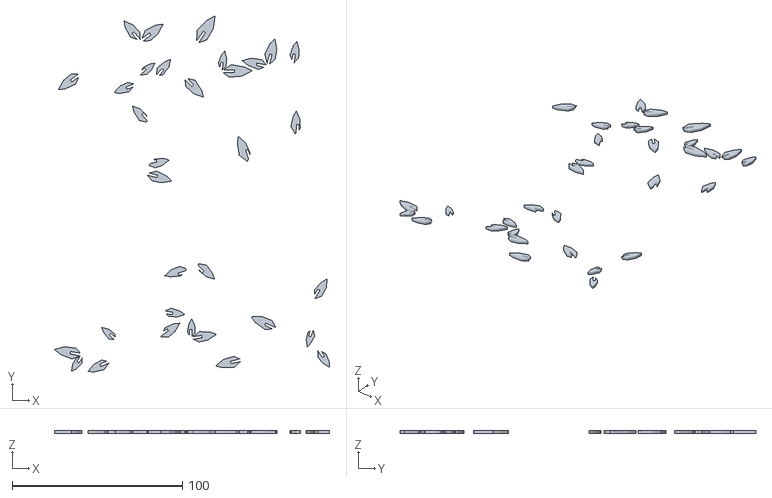
[picture p87: CAD file, 2026-11-12]
hardware/3d-druck/dach-links-blaetter.stl
161.4 x 208.8 x 1.60
