KarlaRuggaber/hands-on-HCI/hardware/3d-druck/platte-1-dach-links.3mf

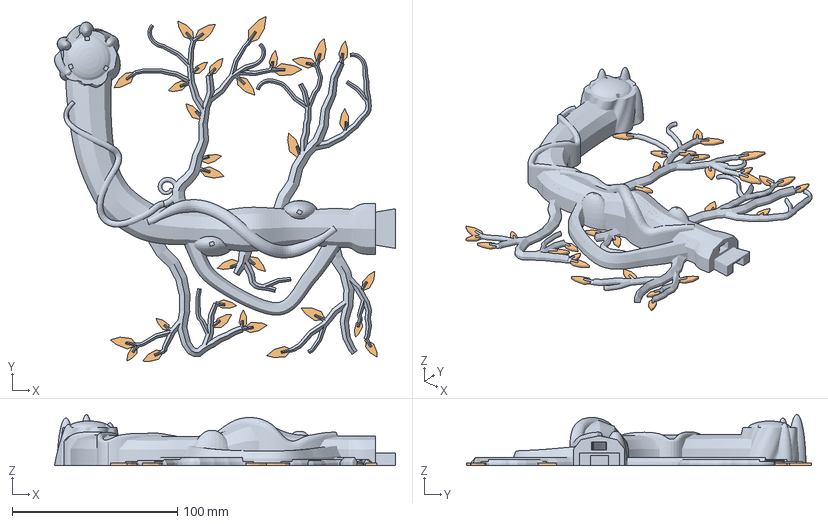
[picture p88: CAD file, 2026-11-12]
hardware/3d-druck/platte-1-dach-links.3mf
206.3 x 208.8 x 31.0 mm
Ast links
Blaetter links
