KarlaRuggaber/hands-on-HCI/hardware/3d-druck/duebel.stl

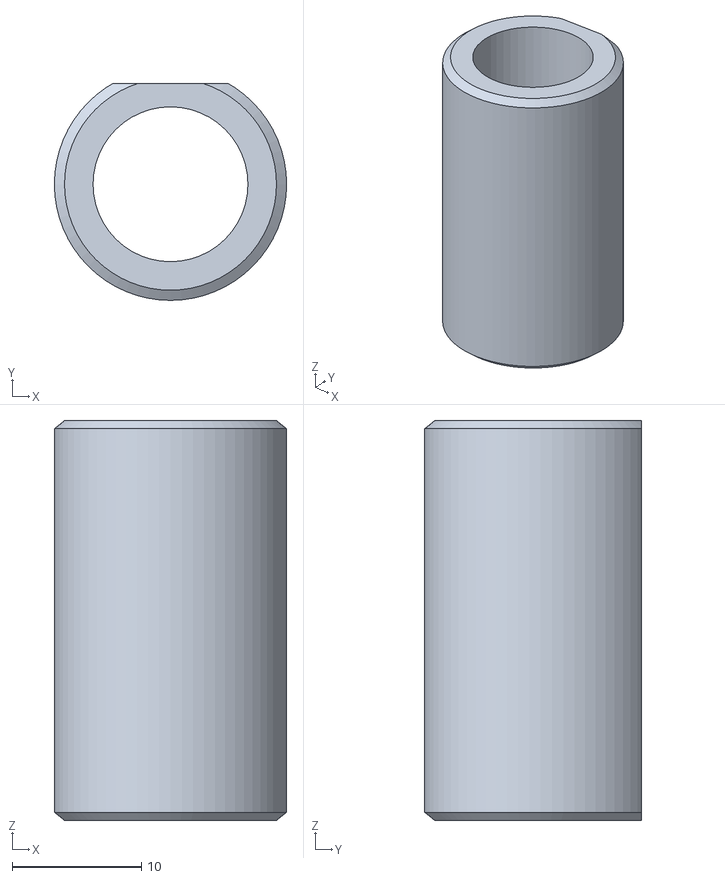
[picture p89: CAD file, 2026-11-12]
hardware/3d-druck/duebel.stl
18.0 x 16.8 x 31.0
