KarlaRuggaber/hands-on-HCI/hardware/3d-druck/stamm-links-oben.stl

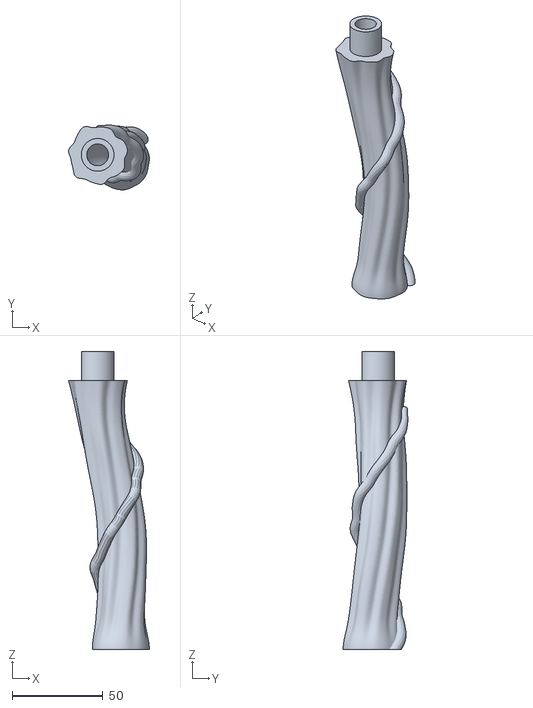
[picture p90: CAD file, 2026-11-12]
hardware/3d-druck/stamm-links-oben.stl
44.5 x 35.7 x 164.0
