KarlaRuggaber/hands-on-HCI/hardware/3d-druck/dach-rechts-blaetter.stl

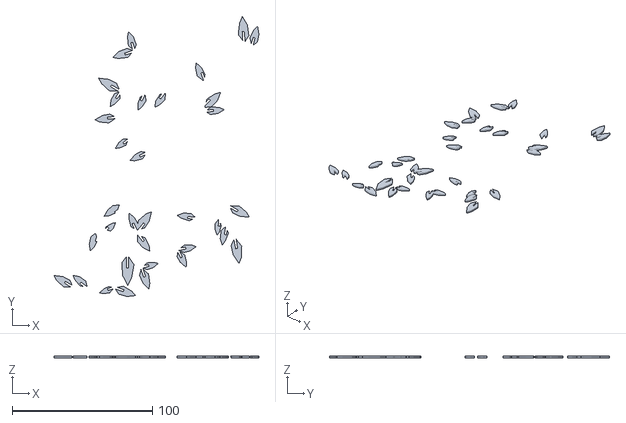
[picture p91: CAD file, 2026-11-12]
hardware/3d-druck/dach-rechts-blaetter.stl
146.1 x 199.6 x 1.60
