KarlaRuggaber/hands-on-HCI/hardware/3d-druck/dach-links-ast.stl

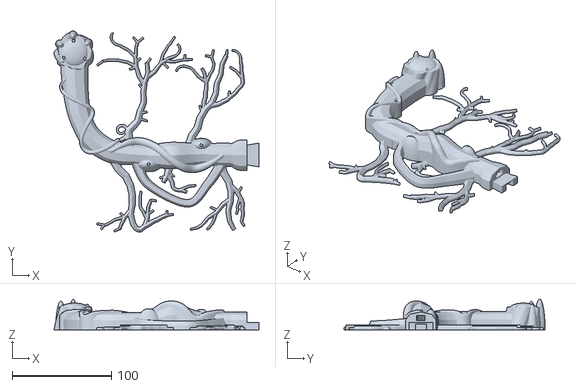
[picture p92: CAD file, 2026-11-12]
hardware/3d-druck/dach-links-ast.stl
206.3 x 202.5 x 31.0
