KarlaRuggaber/hands-on-HCI/hardware/3d-druck/platte-4-staemme-fuesse.3mf

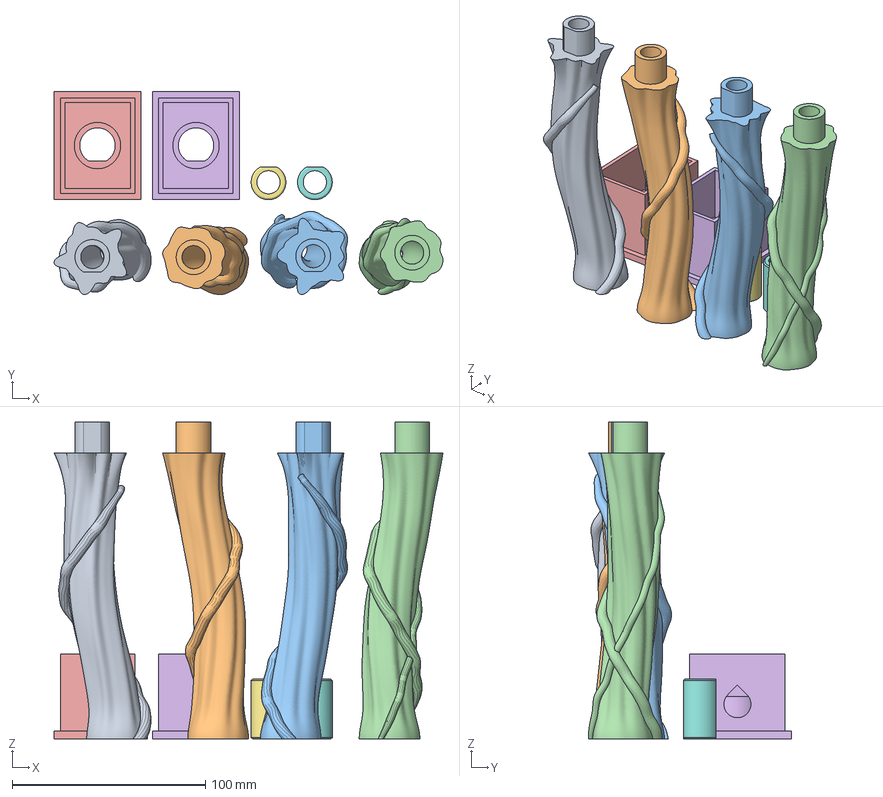
[picture p93: CAD file, 2026-11-12]
hardware/3d-druck/platte-4-staemme-fuesse.3mf
201.3 x 105.1 x 164.0 mm
Stamm links unten
Stamm links oben
Stamm rechts unten
Stamm rechts oben
Pfostenfuss links
Pfostenfuss rechts
Duebel 1
Duebel 2
