KarlaRuggaber/hands-on-HCI/hardware/3d-druck/stamm-rechts-oben.stl

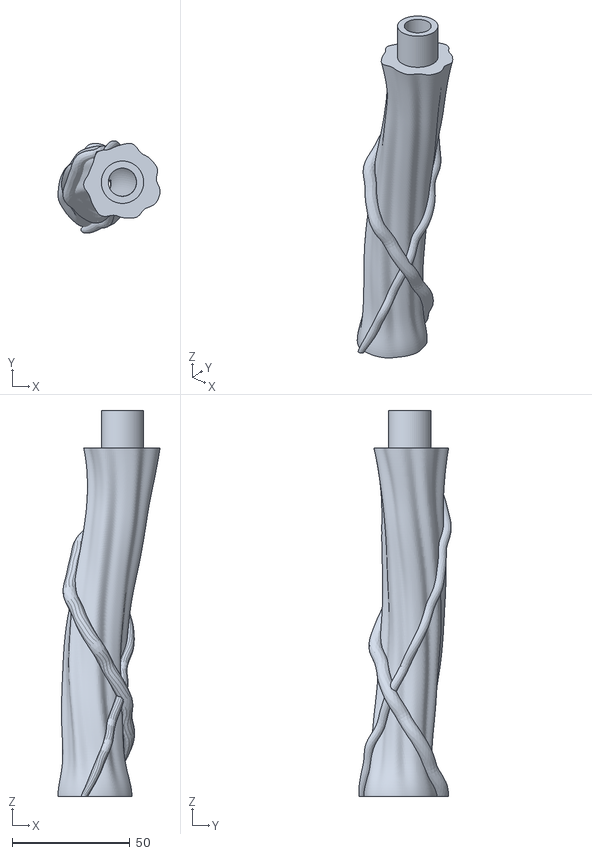
[picture p94: CAD file, 2026-11-12]
hardware/3d-druck/stamm-rechts-oben.stl
43.4 x 39.3 x 164.0
