KarlaRuggaber/hands-on-HCI/hardware/3d-druck/triebe-alle.stl

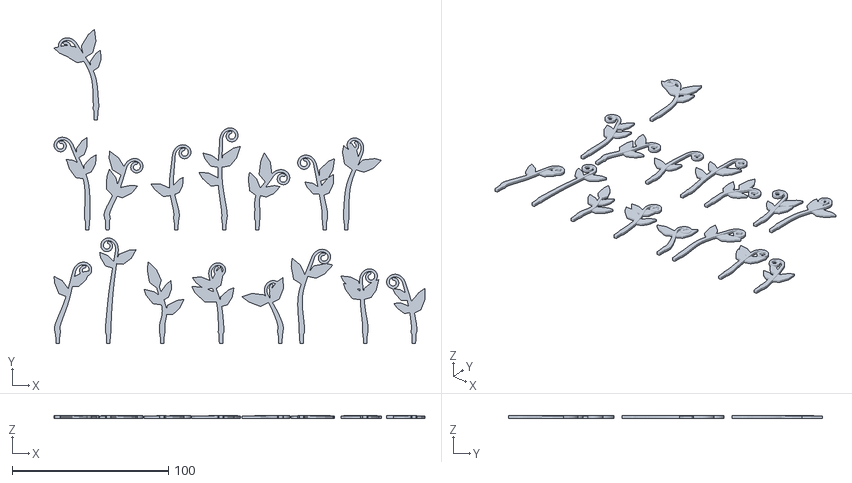
[picture p95: CAD file, 2026-11-12]
hardware/3d-druck/triebe-alle.stl
237.4 x 201.2 x 2.00
