KarlaRuggaber/hands-on-HCI/hardware/3d-druck/dach-rechts-ast.stl

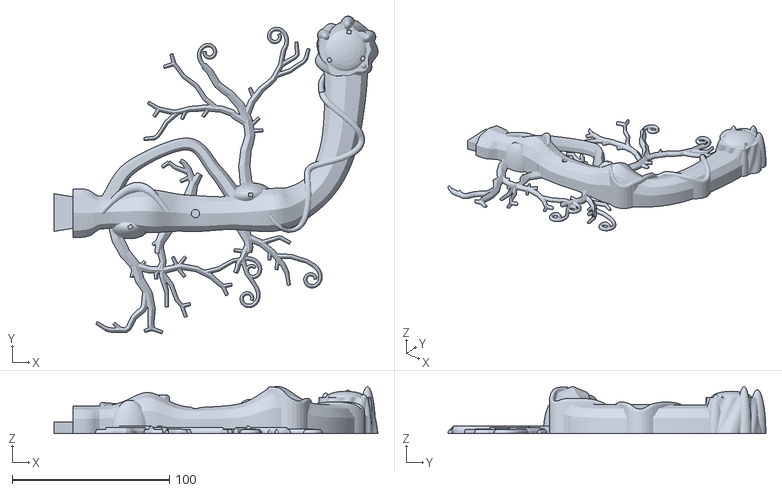
[picture p96: CAD file, 2026-11-12]
hardware/3d-druck/dach-rechts-ast.stl
206.0 x 202.1 x 30.1
