KarlaRuggaber/hands-on-HCI/hardware/3d-druck/stamm-rechts-unten.stl

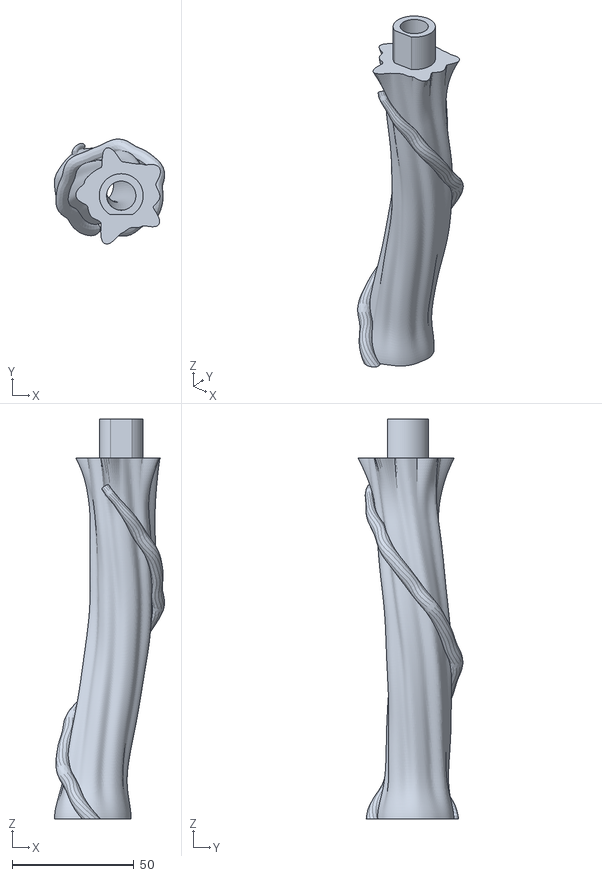
[picture p97: CAD file, 2026-11-12]
hardware/3d-druck/stamm-rechts-unten.stl
45.2 x 43.1 x 164.0
