KarlaRuggaber/hands-on-HCI/hardware/3d-druck/dach-mitte-ast.stl

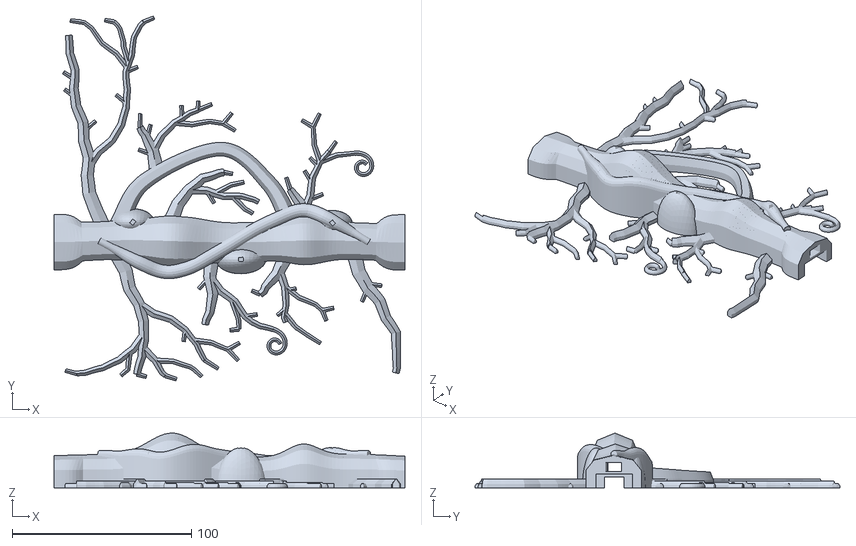
[picture p98: CAD file, 2026-11-12]
hardware/3d-druck/dach-mitte-ast.stl
196.0 x 203.8 x 30.6
