KarlaRuggaber/hands-on-HCI/hardware/3d-druck/platte-3-dach-rechts.3mf

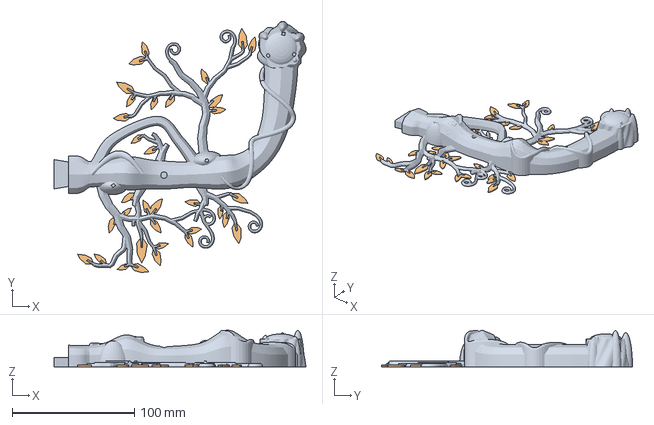
[picture p99: CAD file, 2026-11-12]
hardware/3d-druck/platte-3-dach-rechts.3mf
206.0 x 205.3 x 30.1 mm
Ast rechts
Blaetter rechts
