KarlaRuggaber/hands-on-HCI/hardware/3d-druck/dach-mitte-blaetter.stl

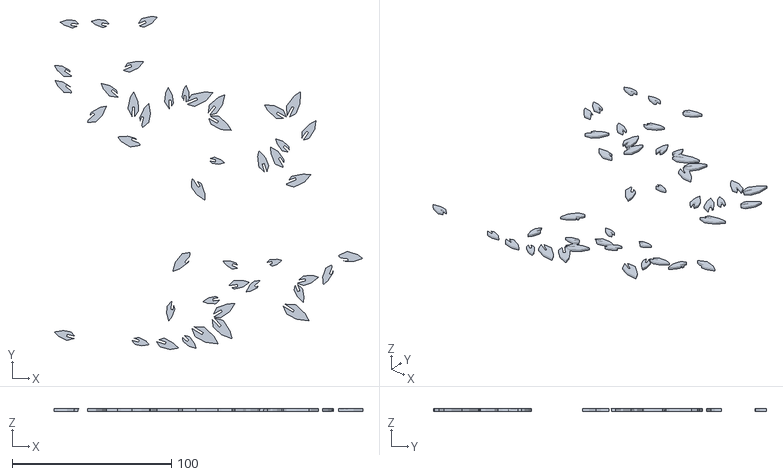
[picture p100: CAD file, 2026-11-12]
hardware/3d-druck/dach-mitte-blaetter.stl
193.9 x 209.2 x 1.60
