KarlaRuggaber/hands-on-HCI/(list of files, cad)

Other CAD files:
hardware/3d-druck/pfostenfuss-rechts.stl
hardware/3d-druck/platte-5-triebe.3mf
