KarlaRuggaber/hands-on-HCI/hardware/steckplan/Group4-Spicetracks-Circuit-Diagram.pdf

Steckplan: ESP32-S3, zwei Breadboards, Relais, Pumpe, Motor, LEDs, Lichtsensor, Pi und vier Kräuter

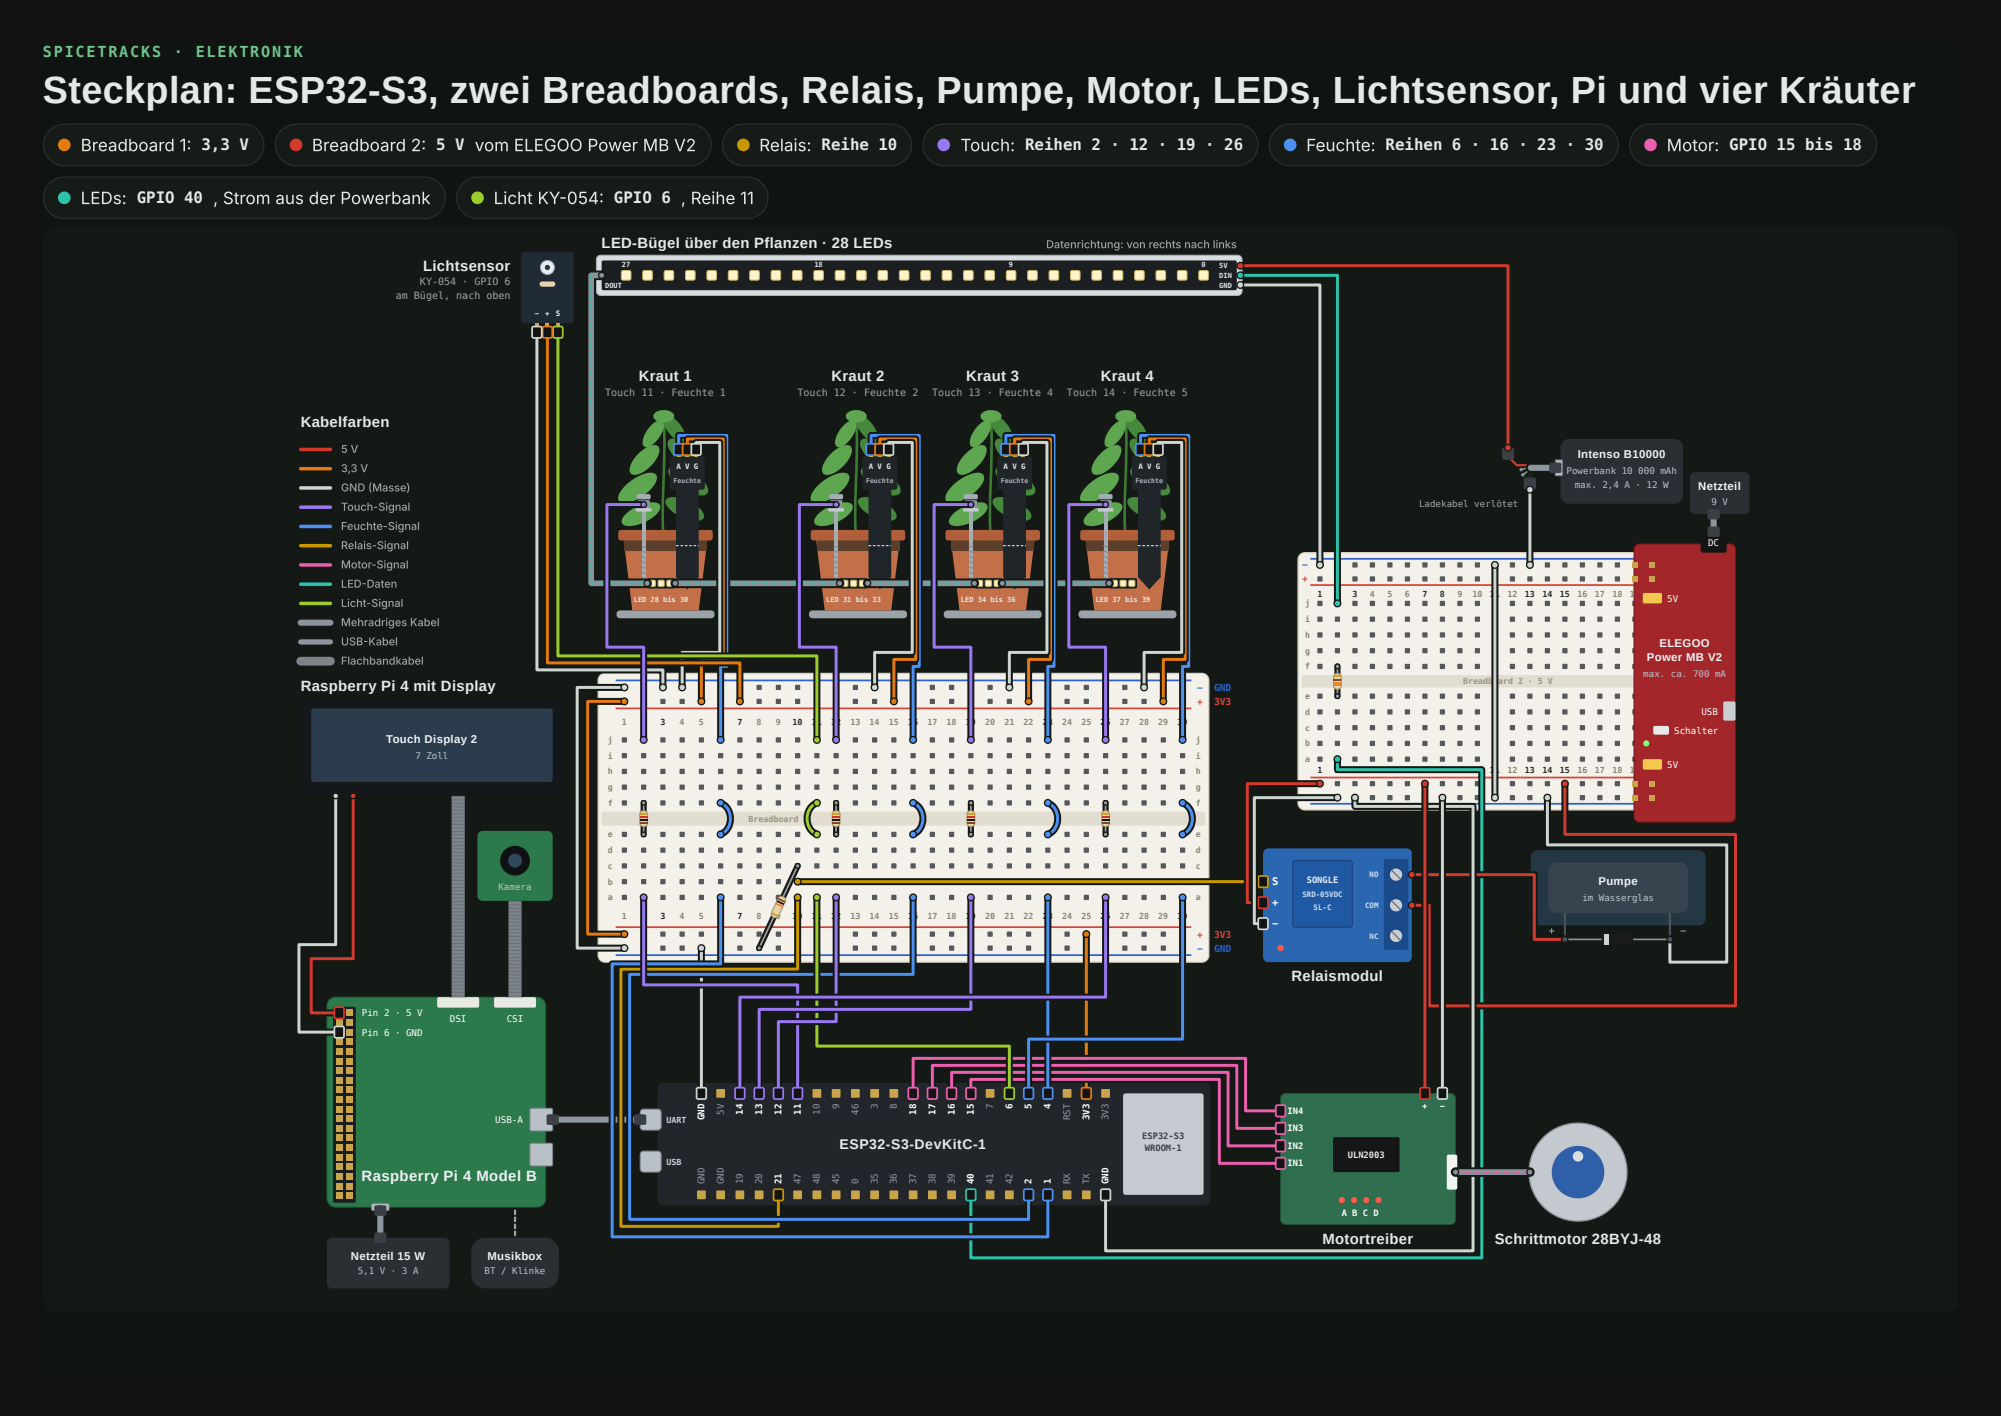
[picture p110: page 1]
SPICETRACKS · ELEKTRONIK; Breadboard 1:; Breadboard 2:; 5 V vom ELEGOO Power MB V2; Relais: Reihe 10; Touch: Reihen 2 · 12 · 19 · 26; Feuchte: Reihen 6 · 16 · 23 · 30; Motor: GPIO 15 bis 18; LEDs: GPIO 40 , Strom aus der Powerbank; Licht KY-054:; GPIO 6 , Reihe 11; Kabelfarben; GND (Masse); Touch-Signal; Feuchte-Signal; Relais-Signal; Motor-Signal; LED-Daten; LED-Bügel über den Pflanzen · 28 LEDs; Datenrichtung: von rechts nach links; DIN; DOUT; GND; Kraut 1; Touch 11 · Feuchte 1; Feuchte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

Lichtsensor
KY-054 · GPIO 6
am Bügel, nach oben

Licht-Signal
Mehradriges Kabel
USB-Kabel
Flachbandkabel
Raspberry Pi 4 mit Display

ELEGOO
Power MB V2
max. ca. 700 mA

Raspberry Pi 4 Model B

# Kabelliste

3,3 V

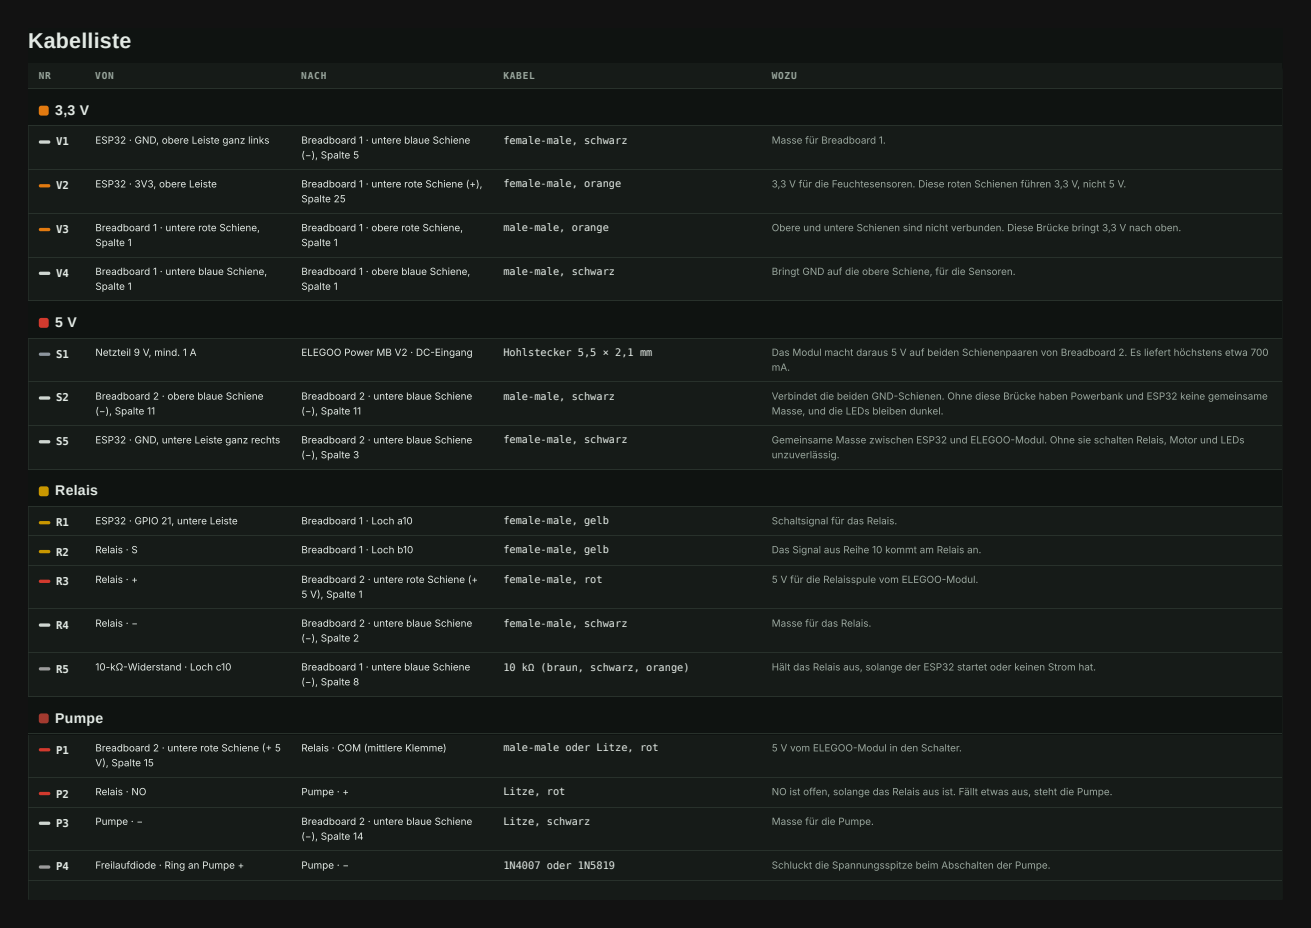
[picture p111: page 2]

Breadboard 1 · obere rote Schiene,
Spalte 1

Breadboard 1 · obere blaue Schiene,

Breadboard 2 · untere blaue Schiene
(−), Spalte 11

Masse, und die LEDs bleiben dunkel.

## Touch

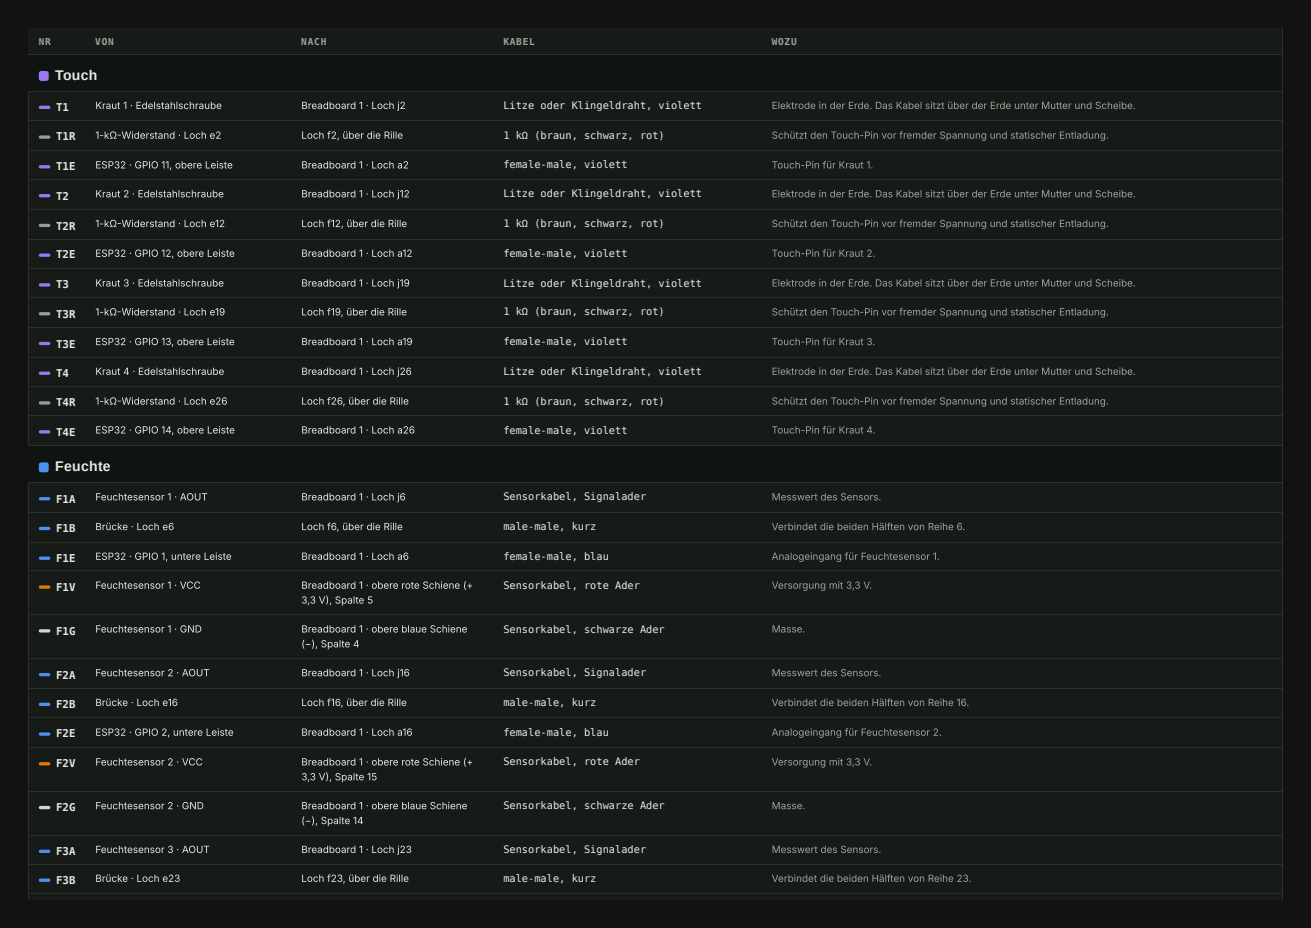
[picture p112: page 3]
Kraut 1 · Edelstahlschraube; Breadboard 1 · Loch j2; Litze oder Klingeldraht, violett; Elektrode in der Erde. Das Kabel sitzt über der Erde unter Mutter und Scheibe.; 1-kΩ-Widerstand · Loch e2; Loch f2, über die Rille; 1 kΩ (braun, schwarz, rot); Schützt den Touch-Pin vor fremder Spannung und statischer Entladung.; ESP32 · GPIO 11, obere Leiste; Breadboard 1 · Loch a2; female-male, violett; Touch-Pin für Kraut 1.; Kraut 2 · Edelstahlschraube; Breadboard 1 · Loch j12; 1-kΩ-Widerstand · Loch e12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

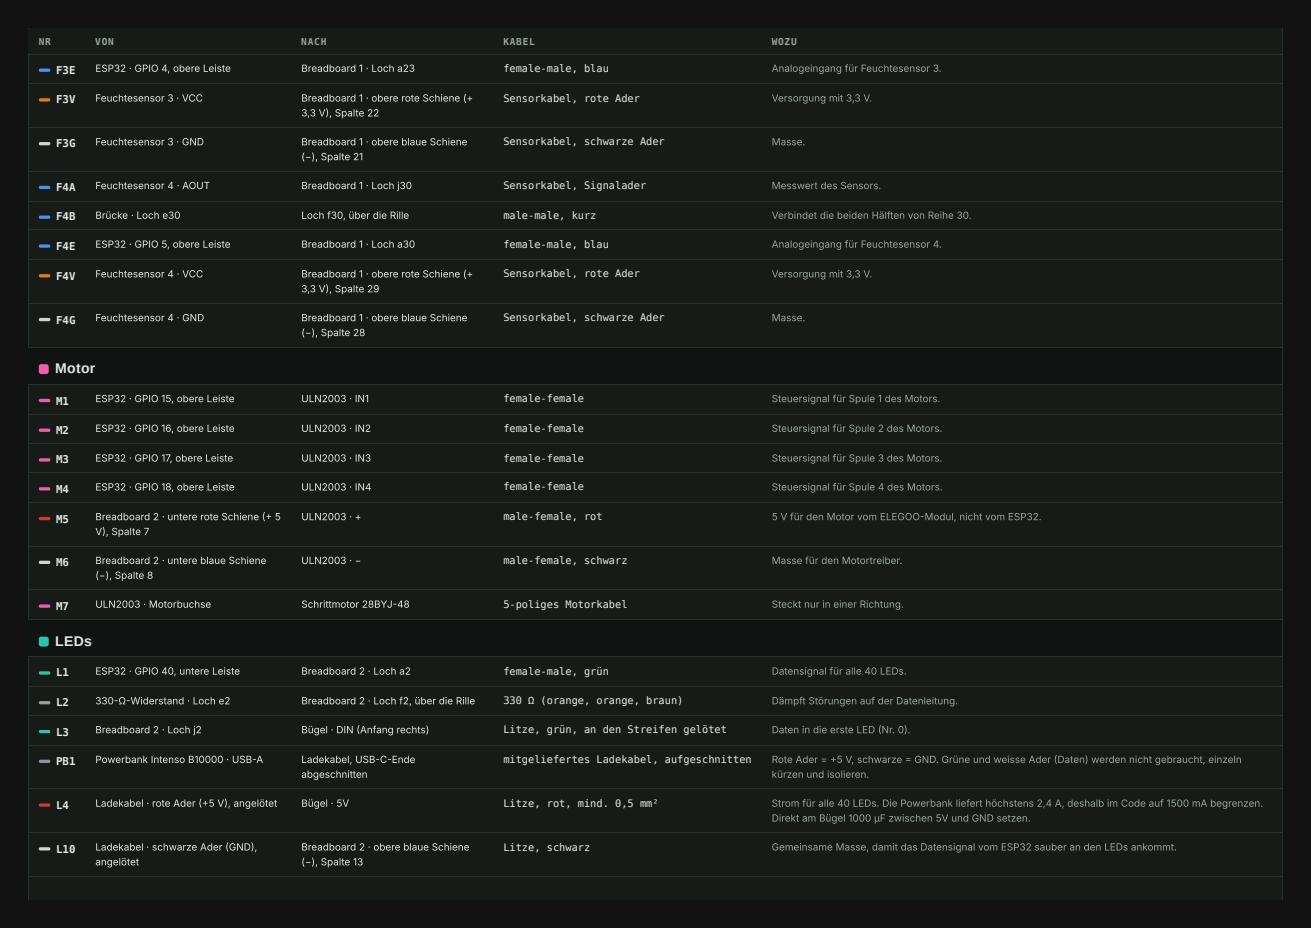
[picture p113: page 4]
ESP32 · GPIO 4, obere Leiste; Breadboard 1 · Loch a23; female-male, blau; Analogeingang für Feuchtesensor 3.; Feuchtesensor 3 · VCC; Breadboard 1 · obere rote Schiene (+; 3,3 V), Spalte 22; Sensorkabel, rote Ader; Versorgung mit 3,3 V.; Feuchtesensor 3 · GND; Breadboard 1 · obere blaue Schiene; (−), Spalte 21; Sensorkabel, schwarze Ader; Masse.; Feuchtesensor 4 · AOUT; Breadboard 1 · Loch j30; Sensorkabel, Signalader; Messwert des Sensors.; Brücke · Loch e30; Loch f30, über die Rille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

kürzen und isolieren.

Direkt am Bügel 1000 µF zwischen 5V und GND setzen.

Breadboard 2 · obere blaue Schiene
(−), Spalte 13

## Licht

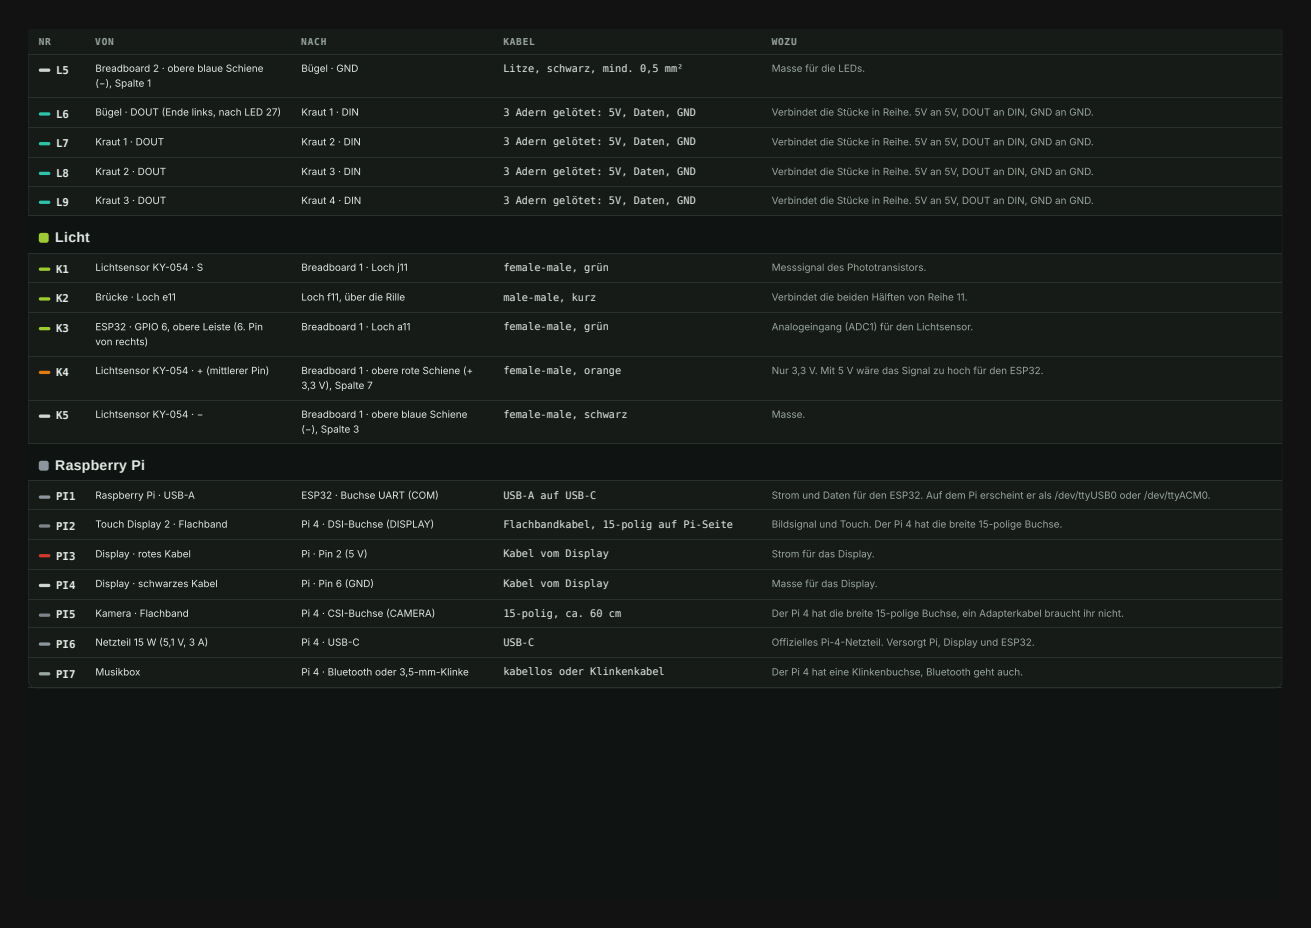
[picture p114: page 5]
Breadboard 2 · obere blaue Schiene; (−), Spalte 1; Bügel · GND; Litze, schwarz, mind. 0,5 mm²; Masse für die LEDs.; Bügel · DOUT (Ende links, nach LED 27); Kraut 1 · DIN; 3 Adern gelötet: 5V, Daten, GND; Verbindet die Stücke in Reihe. 5V an 5V, DOUT an DIN, GND an GND.; Kraut 1 · DOUT; Kraut 2 · DIN; Kraut 2 · DOUT; Kraut 3 · DIN; Kraut 3 · DOUT; Kraut 4 · DIN; Lichtsensor KY-054 · S; Breadboard 1 · Loch j11; female-male, grün; Messsignal des Phototransistors.; Brücke · Loch e11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
